ppeluffo/FWDLGARM_R1/Circuito del contador de pulsos.png

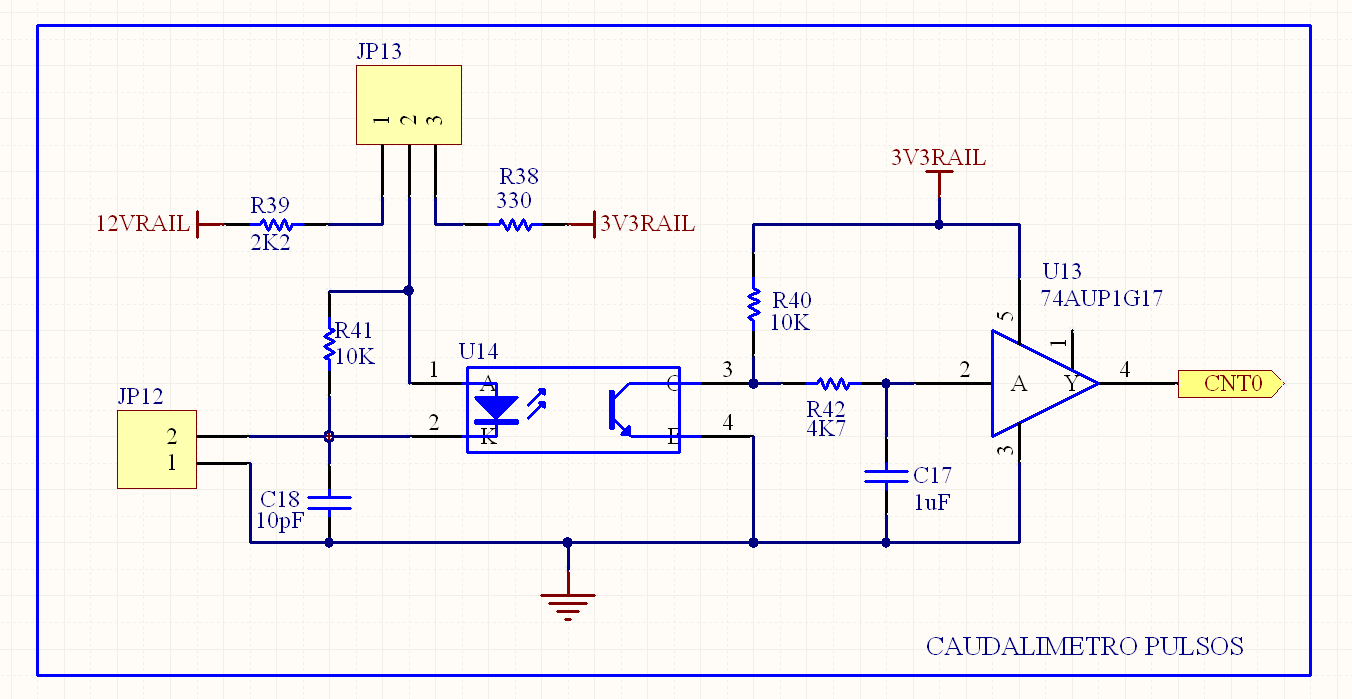
Circuito del contador de pulsos.png
