ppeluffo/FWDLGARM_R1/Fuente de 3V8.png

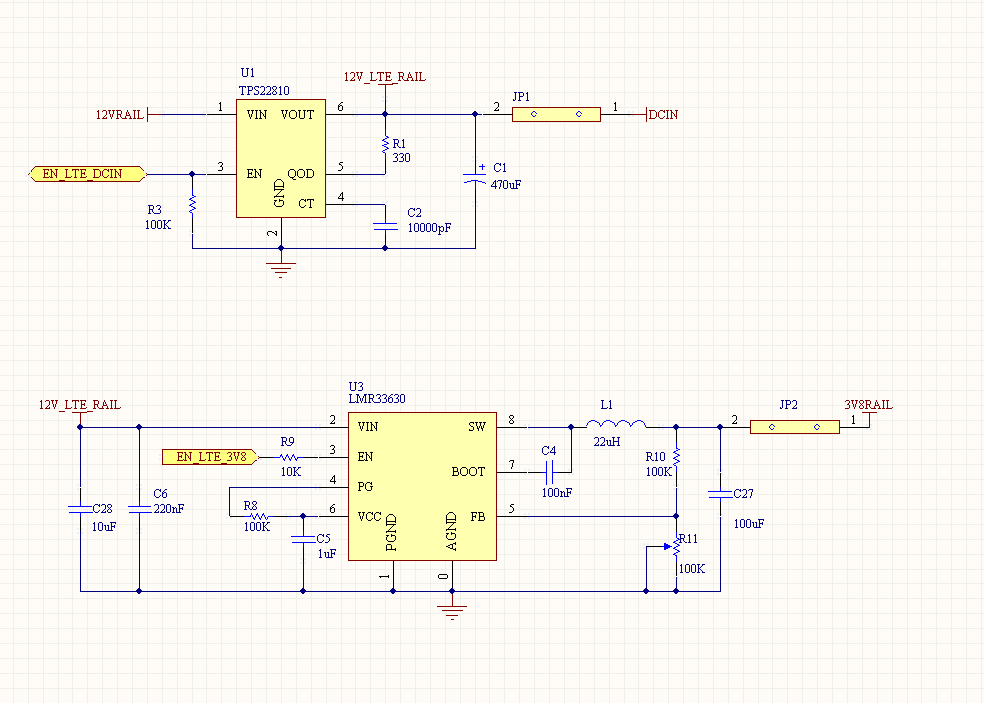
Fuente de 3V8.png
