ppeluffo/FWDLGARM_R1/Nueva fuente 3V8.png

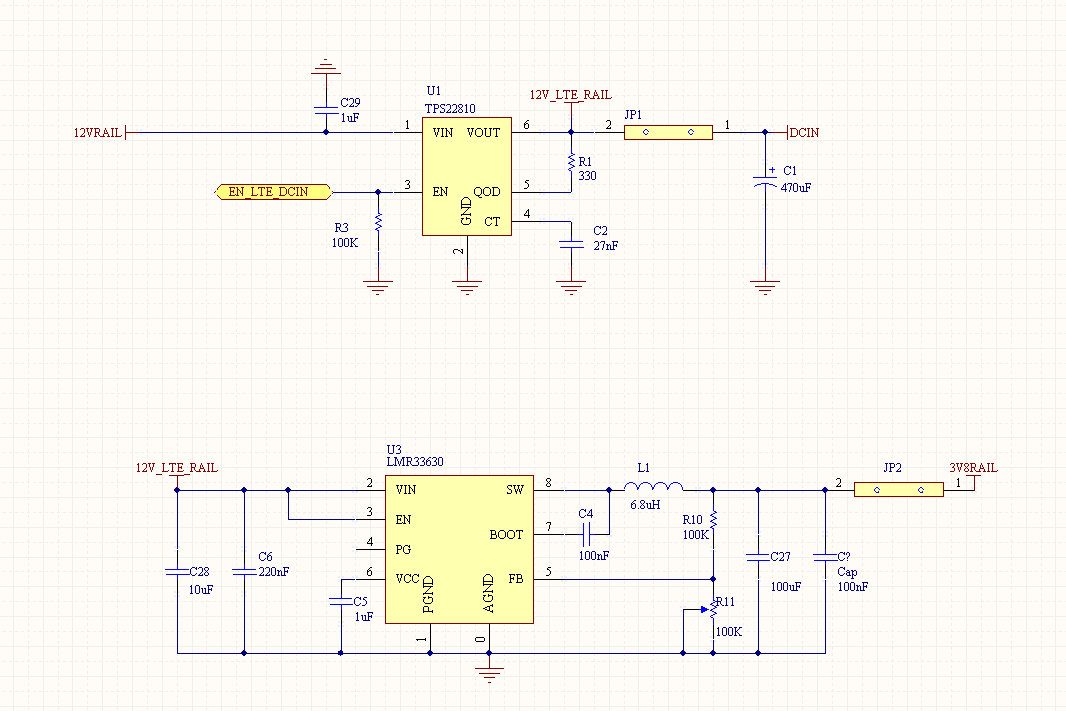
Nueva fuente 3V8.png
