ppeluffo/FWDLGARM_R1/Application/FRTOS-IO/frtos-io.c

/*
 * frtos-io.c  -  ver frtos-io.h
 */

#include <stdio.h>
#include <string.h>

#include "frtos-io.h"
#include "drv_uart.h"
#include "drv_i2c.h"
#include "drv_rs485.h"
#include "semphr.h"

/*------------------------------------------------------------------------------
 * Juego de operaciones de cada clase de periférico.
 *
 * Es lo que reemplaza a las cinco copias de frtos_{read,write,ioctl}_uartN del
 * código AVR: todas las UART comparten estas tres funciones y se distinguen por
 * el campo ucInstancia de la tabla de abajo.
 *----------------------------------------------------------------------------*/
typedef struct {
    int16_t ( *write )( uint8_t ucInstancia, const char *pvBuffer, uint16_t xBytes );
    int16_t ( *read  )( uint8_t ucInstancia, char *pvBuffer, uint16_t xBytes, TickType_t xTicksToWait );
    int16_t ( *ioctl )( uint8_t ucInstancia, uint32_t ulRequest, void *pvValue );
} frtos_ops_t;

/*------------------------------------------------------------------------------
 * Operaciones de UART
 *----------------------------------------------------------------------------*/

static int16_t prvUartWrite( uint8_t ucInstancia, const char *pvBuffer, uint16_t xBytes )
{
    return drv_uart_write( ( drv_uart_id_t ) ucInstancia, pvBuffer, xBytes );
}

static int16_t prvUartRead( uint8_t ucInstancia, char *pvBuffer, uint16_t xBytes, TickType_t xTicksToWait )
{
    return drv_uart_read( ( drv_uart_id_t ) ucInstancia, pvBuffer, xBytes, xTicksToWait );
}

static int16_t prvUartIoctl( uint8_t ucInstancia, uint32_t ulRequest, void *pvValue )
{
    drv_uart_id_t id = ( drv_uart_id_t ) ucInstancia;

    switch( ulRequest )
    {
        case ioctl_UART_CLEAR_RX_BUFFER:
            drv_uart_rx_flush( id );
            return 0;

        case ioctl_UART_ENABLE_RX:
        case ioctl_UART_ENABLE_RX_INT:
            return ( drv_uart_rx_enable( id ) == true ) ? 0 : -1;

        case ioctl_UART_DISABLE_RX:
        case ioctl_UART_DISABLE_RX_INT:
            drv_uart_rx_disable( id );
            return 0;

        case ioctl_SET_TIMEOUT:
            /* El timeout de lectura se pasa por fd, ver xTimeouts. */
            return 0;

        default:
            return -1;
    }
}

static const frtos_ops_t xUartOps = {
    .write = prvUartWrite,
    .read  = prvUartRead,
    .ioctl = prvUartIoctl,
};

/*------------------------------------------------------------------------------
 * Operaciones de I2C
 *
 * El I2C no encaja natural en una API estilo POSIX: `read(fd, buf, n)` no tiene
 * dónde decir a QUÉ chip ni a qué dirección interna. FWDLGX resolvió eso fijando
 * los tres datos por `ioctl` y dejándolos pegados al fd hasta el próximo cambio,
 * y acá se conserva **el mismo idioma con los mismos códigos**, para que el
 * código heredado del AVR compile sin tocarlo:
 *
 *     frtos_ioctl( fdI2C, ioctl_I2C_SET_DEVADDRESS,        &devAddr );
 *     frtos_ioctl( fdI2C, ioctl_I2C_SET_DATAADDRESS,       &memAddr );
 *     frtos_ioctl( fdI2C, ioctl_I2C_SET_DATAADDRESSLENGTH, &largo   );
 *     frtos_read ( fdI2C, buffer, n );
 *
 * ⚠ Es estado pegajoso y compartido: dos tareas usando fdI2C se pisarían los
 * parámetros entre el ioctl y el read, y el mutex de drv_i2c NO protege eso
 * —protege la transacción, que empieza después—. Por eso el acceso a los chips
 * va a ir siempre por sus drivers (EEPROM, RTC), que llaman a `drv_i2c_*`
 * directo y pasan todo junto. Esta fila existe para el código heredado.
 *----------------------------------------------------------------------------*/

static uint8_t  ucI2cDevAddr     = 0U;
static uint16_t usI2cMemAddr     = 0U;
static uint8_t  ucI2cMemAddrLen  = 1U;

static int16_t prvI2cWrite( uint8_t ucInstancia, const char *pvBuffer, uint16_t xBytes )
{
    ( void ) ucInstancia;
    return drv_i2c_write( ucI2cDevAddr, usI2cMemAddr, ucI2cMemAddrLen,
                          pvBuffer, xBytes, portMAX_DELAY );
}

static int16_t prvI2cRead( uint8_t ucInstancia, char *pvBuffer, uint16_t xBytes, TickType_t xTicksToWait )
{
    ( void ) ucInstancia;
    return drv_i2c_read( ucI2cDevAddr, usI2cMemAddr, ucI2cMemAddrLen,
                         pvBuffer, xBytes, xTicksToWait );
}

static int16_t prvI2cIoctl( uint8_t ucInstancia, uint32_t ulRequest, void *pvValue )
{
    ( void ) ucInstancia;

    switch( ulRequest )
    {
        case ioctl_I2C_SET_DEVADDRESS:
            if( pvValue == NULL ) { return -1; }
            ucI2cDevAddr = *( ( uint8_t * ) pvValue );
            return 0;

        case ioctl_I2C_SET_DATAADDRESS:
            if( pvValue == NULL ) { return -1; }
            usI2cMemAddr = *( ( uint16_t * ) pvValue );
            return 0;

        case ioctl_I2C_SET_DATAADDRESSLENGTH:
            if( pvValue == NULL ) { return -1; }
            ucI2cMemAddrLen = *( ( uint8_t * ) pvValue );
            return 0;

        case ioctl_I2C_GET_LAST_ERROR:
            if( pvValue == NULL ) { return -1; }
            *( ( uint32_t * ) pvValue ) = drv_i2c_last_error();
            return 0;

        case ioctl_I2C_RESET:
            return ( drv_i2c_reset() == true ) ? 0 : -1;

        default:
            return -1;
    }
}

static const frtos_ops_t xI2cOps = {
    .write = prvI2cWrite,
    .read  = prvI2cRead,
    .ioctl = prvI2cIoctl,
};

/*------------------------------------------------------------------------------
 * La tabla de file descriptors.
 *
 * Las filas en NULL son los periféricos cuyo hardware todavía no está poblado:
 * el fd existe para que el código de aplicación compile, pero cualquier
 * operación devuelve -1 en vez de escribir en un periférico inexistente.
 *----------------------------------------------------------------------------*/
typedef struct {
    const frtos_ops_t *pxOps;
    uint8_t            ucInstancia;
} frtos_fd_t;

static const frtos_fd_t xFdTable[ fdCOUNT ] = {
    [ fdTERM   ] = { &xUartOps, drvUART_TERM },
    [ fdWAN    ] = { &xUartOps, drvUART_LTE },
    [ fdRS485A ] = { &xUartOps, drvUART_RS485 },
    [ fdI2C    ] = { &xI2cOps, 0 },
    [ fdNVM    ] = { NULL, 0 },
};

/* Timeout de lectura por fd, lo fija ioctl_SET_TIMEOUT. Arranca en portMAX_DELAY:
   una lectura sin timeout explícito bloquea, que es lo que quiere la consola. */
static TickType_t xTimeouts[ fdCOUNT ];

static inline const frtos_fd_t *prvFd( file_descriptor_t fd )
{
    if( ( fd >= fdCOUNT ) || ( xFdTable[ fd ].pxOps == NULL ) )
    {
        return NULL;
    }
    return &xFdTable[ fd ];
}

/*------------------------------------------------------------------------------
 * API genérica
 *----------------------------------------------------------------------------*/

bool frtos_open_all( void )
{
    for( uint32_t i = 0U; i < fdCOUNT; i++ )
    {
        xTimeouts[ i ] = portMAX_DELAY;
    }

    /* El orden importa: drv_rs485_init() apaga rieles y toca la recepción de la
       UART del 485, así que la UART tiene que existir antes. */
    return ( drv_uart_init() && drv_i2c_init() && drv_rs485_init() );
}
//------------------------------------------------------------------------------
int16_t frtos_write( file_descriptor_t fd, const char *pvBuffer, uint16_t xBytes )
{
    const frtos_fd_t *px = prvFd( fd );

    return ( px != NULL ) ? px->pxOps->write( px->ucInstancia, pvBuffer, xBytes ) : -1;
}
//------------------------------------------------------------------------------
int16_t frtos_read( file_descriptor_t fd, char *pvBuffer, uint16_t xBytes )
{
    const frtos_fd_t *px = prvFd( fd );

    return ( px != NULL ) ? px->pxOps->read( px->ucInstancia, pvBuffer, xBytes, xTimeouts[ fd ] ) : -1;
}
//------------------------------------------------------------------------------
int16_t frtos_ioctl( file_descriptor_t fd, uint32_t ulRequest, void *pvValue )
{
    const frtos_fd_t *px = prvFd( fd );

    if( px == NULL )
    {
        return -1;
    }

    /* El timeout lo administra esta capa, no el driver: es una propiedad del fd. */
    if( ulRequest == ioctl_SET_TIMEOUT )
    {
        xTimeouts[ fd ] = ( pvValue != NULL ) ? *( ( TickType_t * ) pvValue ) : portMAX_DELAY;
        return 0;
    }

    return px->pxOps->ioctl( px->ucInstancia, ulRequest, pvValue );
}

/*------------------------------------------------------------------------------
 * printf
 *----------------------------------------------------------------------------*/

static char              cPrintfBuffer[ XPRINTF_BUFFER_SIZE ];
static SemaphoreHandle_t xPrintfMutex = NULL;
static StaticSemaphore_t xPrintfMutexCtrl;

static int prvVfprintf( file_descriptor_t fd, const char *fmt, va_list ap )
{
    /* Creación perezosa: xprintf() puede llamarse antes de frtos_open_all(). */
    if( xPrintfMutex == NULL )
    {
        xPrintfMutex = xSemaphoreCreateMutexStatic( &xPrintfMutexCtrl );
    }

    if( xSemaphoreTake( xPrintfMutex, portMAX_DELAY ) != pdTRUE )
    {
        return -1;
    }

    int iLen = vsnprintf( cPrintfBuffer, sizeof( cPrintfBuffer ), fmt, ap );

    if( iLen > 0 )
    {
        /* vsnprintf devuelve lo que HABRÍA escrito: si no entró, se manda lo que hay. */
        if( iLen >= ( int ) sizeof( cPrintfBuffer ) )
        {
            iLen = ( int ) sizeof( cPrintfBuffer ) - 1;
        }
        ( void ) frtos_write( fd, cPrintfBuffer, ( uint16_t ) iLen );
    }

    ( void ) xSemaphoreGive( xPrintfMutex );

    return iLen;
}
//------------------------------------------------------------------------------
int xprintf( const char *fmt, ... )
{
    va_list ap;
    va_start( ap, fmt );
    int iRet = prvVfprintf( fdTERM, fmt, ap );
    va_end( ap );
    return iRet;
}
//------------------------------------------------------------------------------
int xfprintf( file_descriptor_t fd, const char *fmt, ... )
{
    va_list ap;
    va_start( ap, fmt );
    int iRet = prvVfprintf( fd, fmt, ap );
    va_end( ap );
    return iRet;
}
//------------------------------------------------------------------------------
void xputChar( char c )
{
    ( void ) frtos_write( fdTERM, &c, 1U );
}
//------------------------------------------------------------------------------
