ppeluffo/FWDLGARM_R1/Application/tasks/wan_frame.h

/*
 * wan_frame.h
 *
 * El FRAME: la serialización de un `dataRcd_t` en el formato que entiende el
 * servidor. Portado de `wan_load_dr_in_txbuffer()` de FWDLGX 2.0.12
 * (`SRC/TASKS/FWDLGX_tkWAN.c`).
 *
 * ---------------------------------------------------------------------------
 * ⭐ ESTE ARCHIVO ES EL CONTRATO. NO ES UNA DECISIÓN DE DISEÑO.
 *
 * El servidor está en producción y no se toca. Pablo lo puso como la única
 * condición dura de la migración: *"Es importante mantener el formato de los
 * frames de datos ya que el servidor debe poder entendernos"*.
 *
 * O sea que acá **no se mejora nada**: ni el orden de los campos, ni la
 * cantidad de decimales, ni los nombres. Si algo parece raro —y hay cosas que lo
 * parecen— es porque así lo espera el otro lado.
 *
 * El formato:
 *
 *     ID=<imei>&HW=<hw>&TYPE=<type>&VER=<ver>&CLASS=DATA
 *     &DATE=YYMMDD&TIME=HHMMSS
 *     &<nombre>=%0.2f     por cada analógica HABILITADA
 *     &<nombre>=%0.3f     el contador, si está habilitado
 *     &<nombre>=%0.3f     por cada canal modbus habilitado
 *     &V0=<0|1>           la válvula: 0 = abierta, 1 = cerrada
 *     &bt3v3=%0.3f
 *     &bt12v=%0.3f
 *
 * Tres cosas que hay que tener presentes:
 *
 *  - **Los nombres de los campos salen de la configuración**, no son fijos: el
 *    servidor los aprende del frame de configuración. Por eso dos canales con el
 *    mismo nombre rompen el frame — ver `cfg_nvm_chequear_nombres()`.
 *  - **Sólo se emiten los canales habilitados**, así que el conjunto de campos
 *    varía de equipo a equipo.
 *  - **Las precisiones son distintas a propósito**: 2 decimales las analógicas,
 *    3 el contador y los modbus. No unificarlas.
 *
 * `CLASS=DATA` espera respuesta del servidor; `CLASS=DATANR` no ("no response"),
 * y es lo que se usa al vaciar la memoria de golpe.
 *
 * ---------------------------------------------------------------------------
 * EL CENTINELA -9999 (decisión de Pablo, 2026-09-08)
 *
 * Un campo que no se pudo medir viaja como **-9999**, no se omite.
 *
 * El razonamiento es de Pablo y es el correcto: *"si no lo transmitimos el
 * servidor no lo detecta"*. Un campo **ausente** se confunde con un canal
 * deshabilitado y pasa desapercibido; un **-9999** salta a la vista, y como las
 * magnitudes que mide este equipo son positivas, no puede confundirse con una
 * medida real.
 *
 * Es el mismo criterio que el `SIN_DATO` de la consola, la firma del MCP79410
 * para la hora y el `estado_asumido` de la válvula: **hacer visible lo que no se
 * sabe**, en vez de dejar que se mezcle con lo que sí.
 *
 * ⚠ La HORA es la excepción, y no por descuido: no es un campo numérico, así que
 * el centinela no aplica. Si el reloj arrancó frío viaja su fecha tal cual
 * —`010101`— que del lado del servidor es tan detectable como un -9999.
 */

#ifndef APPLICATION_TASKS_WAN_FRAME_H_
#define APPLICATION_TASKS_WAN_FRAME_H_

#include <stdbool.h>
#include <stdint.h>

#include "tkSys.h"
#include "drv_rtc79410.h"

/* Lo que va en un campo que no se pudo medir. Ver arriba. */
#define WAN_CENTINELA_SIN_DATO      ( -9999.0f )

/*
 * 512 bytes. En el AVR eran 255 y **se desbordaban**: con los 9 canales
 * habilitados y nombres normales el frame pasa de 255 y allá corrompía variables
 * globales — está documentado en el propio `wan_load_dr_in_txbuffer()`. Acá la
 * RAM sobra, así que el buffer se dimensionó para el peor caso con holgura.
 */
#define WAN_FRAME_BUFFER_SIZE       512U

/*------------------------------------------------------------------------------
 * Arma el frame de datos en `pcBuf`. Devuelve los bytes escritos (sin el NUL), o
 * 0 si no entró — y en ese caso lo avisa por consola en vez de mandar un frame
 * truncado, que del otro lado sería un registro con campos perdidos.
 *
 * `bConRespuesta` elige entre `CLASS=DATA` y `CLASS=DATANR`.
 *----------------------------------------------------------------------------*/
uint16_t wan_frame_data( char *pcBuf, uint16_t usSize, const dataRcd_t *pxDr,
                         bool bConRespuesta );

/*------------------------------------------------------------------------------
 * EL FRAME PARTIDO EN DOS, y por qué (decisión de Pablo, 2026-09-21)
 *
 *   wan_frame_prefijo()  ID=<imei>&HW=..&TYPE=..&VER=..&CLASS=..
 *   wan_frame_datos()    DATE=..&TIME=..&<canales>&V0=..&bt3v3=..&bt12v=..
 *
 * `wan_frame_data()` es la concatenación de las dos con un `&` en el medio, y
 * es lo que se transmite. **El formato que viaja no cambia en un solo byte.**
 *
 * ⭐ **La partición existe porque en la microSD se guarda SÓLO la parte de
 * datos**, y el prefijo se construye al transmitir. Lo que hay en el prefijo no
 * pertenece al dato, pertenece al transporte:
 *
 *  - ⛔ **`ID` es el IMEI del módulo.** Guardándolo, un lote que quede pendiente
 *    y se transmita después de cambiar el módulo LTE **saldría con el IMEI
 *    viejo**, y el servidor lo atribuiría a otro equipo o lo rechazaría. No es
 *    hipotético: el módulo de este banco ya se movió a un AVR para una prueba.
 *  - **`CLASS` es una decisión de transmisión**, no del dato: el mismo registro
 *    va como `DATANR` o como `DATA` según cierre bloque o no. Guardarlo obligaba
 *    a reescribirlo al transmitir.
 *  - `HW`/`TYPE` no cambian nunca, y `VER` congelado hasta sería deseable — pero
 *    no valen el precio de los dos primeros.
 *
 * De yapa la línea del lote baja de ~120 a ~55 bytes, menos de la mitad.
 *
 * ⭐ Y se conserva **la razón principal** por la que en la SD van frames de
 * texto y no registros binarios: los **nombres de los canales** siguen
 * guardados con los que se midió, así que no reaparece el problema de
 * "configuración nueva con datos viejos".
 *----------------------------------------------------------------------------*/
uint16_t wan_frame_prefijo( char *pcBuf, uint16_t usSize, bool bConRespuesta );
uint16_t wan_frame_datos  ( char *pcBuf, uint16_t usSize, const dataRcd_t *pxDr );

/*------------------------------------------------------------------------------
 * El IMEI, que es el `ID` con el que el servidor identifica al equipo.
 *
 * ⏳ **HOY DEVUELVE UN IMEI FALSO, Y ES PROVISORIO DE ESTA ETAPA** (acordado con
 * Pablo, 2026-09-08): esta etapa no incluye el modem, así que no hay de dónde
 * sacar el real.
 *
 * **Lo definitivo, para el paso 5**: tkWAN prende el modem al arrancar, le
 * pregunta el IMEI con `AT+IMEI?` y lo cachea; **queda fijado aunque después el
 * modem se apague**, así que el frame nunca necesita el modem encendido para
 * armarse. Sólo hay que reemplazar lo que devuelve esta función.
 *
 * ⚠ **El valor falso son 15 ceros a propósito.** Es sintácticamente un IMEI, así
 * que no rompe el parseo del servidor, pero **ningún equipo real lo tiene**: si
 * un frame de prueba llegara por error al servidor de producción, sería
 * rechazado como equipo desconocido en vez de mezclarse con los datos de un
 * datalogger que existe. Por eso no se usó el IMEI de un módulo real de los que
 * andan dando vueltas en las notas.
 *----------------------------------------------------------------------------*/
const char *wan_imei( void );

/*------------------------------------------------------------------------------
 * true mientras el IMEI siga siendo el falso de 15 ceros, o sea **mientras nadie
 * se lo haya preguntado al módulo**.
 *
 * ⛔ Existe porque el 2026-09-21 se transmitió una sesión entera con los ceros
 * sin que nada lo dijera: el IMEI se cachea recién cuando alguien corre
 * `lte info`, y esa corrida empezó con `lte clock set`. El servidor aceptó los
 * frames igual, así que **quedaron en la base atribuidos a un equipo que no
 * existe** — y del lado del datalogger no hubo ni una señal.
 *
 * Quien vaya a transmitir tiene que consultarlo y avisar. ⏳ Cuando exista la
 * FSM (paso 5d), el IMEI se lee al abrir la sesión y esto pasa a ser una red de
 * seguridad en vez del mecanismo principal.
 *----------------------------------------------------------------------------*/
bool wan_imei_es_falso( void );

/*------------------------------------------------------------------------------
 * Fija el IMEI leído del módulo. Lo llama quien haya hecho el `AT+IMEI?`.
 *
 * Se guarda **una vez por corrida**: el módulo puede apagarse entre sesiones,
 * pero su IMEI no cambia. Así el frame se arma sin necesitar el modem encendido.
 *----------------------------------------------------------------------------*/
void wan_imei_set( const char *pcImei );

/*------------------------------------------------------------------------------
 * Los otros dos datos que el módulo sabe y el frame de configuración necesita.
 *
 * `ICCID` identifica a la SIM y `CSQ` es la calidad de señal — los dos se leen
 * con AT y se cachean, igual que el IMEI.
 *
 * ⚠ **El `CSQ` que viaja en el frame NO es el `rssi` crudo del módulo**: es el
 * valor absoluto de los dBm, `|dBm| = 113 - 2·rssi`, que es lo que manda el AVR
 * (`+CSQ: 20,99` → `CSQ=73`). Convertirlo acá y no en el frame deja el dato
 * listo en la unidad del contrato.
 *
 * ⚠ Y dos valores de `rssi` NO son medidas, son centinelas —lo descubrió el AVR
 * en mayo de 2026 y a nosotros nos costó una tarde el 2026-09-09—:
 *
 *   - **99** = "desconocido / no detectable" (3GPP).
 *   - **>= 31** = lo que devuelve el módulo **ANTES de campar en la red**. Se ve
 *     como señal excelente y no lo es: le sigue un `+CME ERROR:50` en `AT+CIP?`
 *     y el equipo no transmite nada.
 *----------------------------------------------------------------------------*/
void wan_iccid_set( const char *pcIccid );
void wan_csq_set  ( uint8_t ucRssi );

const char *wan_iccid( void );
uint8_t     wan_csq  ( void );      /* ya convertido a |dBm| */

/* true si el `rssi` crudo era una medida y no un centinela. */
bool wan_csq_valido( void );

/*------------------------------------------------------------------------------
 * El frame de CONFIGURACIÓN: manda un hash por bloque y el servidor contesta
 * cuáles quiere reconfigurar.
 *
 * ⛔ **Van CINCO hashes: el `FH` de flowcontrol NO se manda, y es deliberado.**
 *
 * Ese bloque llegó a estar implementado —configuración, hash y parseo— y **se
 * eliminó entero el 2026-09-22** por decisión de Pablo: *"Esta es una
 * funcionalidad que aún no la estamos usando, así que no vamos a ensuciar el
 * firmware con features que no se usan."*
 *
 * ⚠ **Y el servidor se ajustó para acompañarlo**: ya no pide `FLOWC` ni espera
 * su hash. O sea que esto **no es la situación transitoria de antes** —donde
 * `CONF_ALL` nunca podía cerrar porque faltaba un hash que el servidor sí
 * esperaba—: ahora las dos puntas están de acuerdo en que son cinco.
 *
 * ⭐ **La regla de que la FSM pase a transmitir datos aunque queden bloques
 * pedidos sigue valiendo igual.** Era lo correcto cuando existía el `FLOWC` que
 * no se podía satisfacer, y lo sigue siendo ante *cualquier* bloque que falle:
 * si esperara el `OK`, uno solo rechazado dejaría al equipo sin transmitir una
 * muestra.
 */
uint16_t wan_frame_conf_all( char *pcBuf, uint16_t usSize );

/*------------------------------------------------------------------------------
 * Qué pidió reconfigurar el servidor. `bFlowcontrol` se parsea igual **aunque no
 * se implemente**: verlo en la consola explica por qué la configuración nunca
 * cierra, y sin eso parecería un error.
 *----------------------------------------------------------------------------*/
typedef struct {
    bool bBase;
    bool bAinputs;
    bool bCounter;
    bool bModbus;
    bool bConsigna;
    /* ⚠ Se PARSEA aunque el bloque no exista: si un servidor viejo lo pidiera,
       verlo en la consola explica por qué la configuración no cierra. Sin esto
       parecería un error del equipo. */
    bool bFlowcontrol;
} wan_conf_flags_t;

typedef enum {
    wanCONF_OK = 0,         /* CONFIG=OK: no hay nada que reconfigurar        */
    wanCONF_RECONFIGURAR,   /* el servidor listó bloques -> ver las flags     */
    wanCONF_DESCONOCIDO,    /* CONFIG=ERROR / FAIL: no nos reconoce           */
    wanCONF_SIN_RESPUESTA
} wan_conf_rta_t;

wan_conf_rta_t wan_frame_conf_all_rta( const char *pcRta, wan_conf_flags_t *pxFlags );

/*------------------------------------------------------------------------------
 * Los bloques de configuración, en el orden en que se los pide.
 *----------------------------------------------------------------------------*/
typedef enum {
    wanBLOQUE_BASE = 0,
    wanBLOQUE_AINPUTS,
    wanBLOQUE_COUNTER,
    wanBLOQUE_MODBUS,
    wanBLOQUE_CONSIGNA,
    wanBLOQUE_NRO          /* centinela: cuántos son */
} wan_bloque_t;

/* El nombre de la clase tal como viaja: "CONF_BASE", "CONF_AINPUTS", … */
const char *wan_conf_clase( wan_bloque_t eBloque );

/* true si el servidor pidió reconfigurar ESE bloque. Evita que cada llamador
   tenga que escribir su propio switch sobre los campos de la struct. */
bool wan_conf_pedido( const wan_conf_flags_t *pxFlags, wan_bloque_t eBloque );

/*------------------------------------------------------------------------------
 * El frame de un bloque: manda su hash y el servidor contesta con la
 * configuración que quiere que tenga el equipo.
 *
 * ⚠ **`CONF_BASE` lleva UID, ICCID, CSQ y WDG; los otros cuatro NO.** Es una
 * asimetría del AVR —ver `wan_process_frame_configBase()` contra los otros
 * cuatro— y se reproduce tal cual: es el contrato, no una decisión.
 *----------------------------------------------------------------------------*/
uint16_t wan_frame_conf_bloque( char *pcBuf, uint16_t usSize, wan_bloque_t eBloque );

/*------------------------------------------------------------------------------
 * Parsea la respuesta de un bloque y **aplica la configuración en RAM**.
 *
 * Formatos (los del AVR, `wan_process_rsp_config*`):
 *
 *   CLASS=CONF_BASE&TPOLL=30&TDIAL=900&PWRMODO=CONTINUO&PWRON=1800&PWROFF=1440
 *   CLASS=CONF_AINPUTS&PST=12&A0=true,pA,4,20,0.0,10.0,0.0&A1=…&A2=…
 *   CLASS=CONF_COUNTERS&C0=TRUE,CAU0,5.3,CAUDAL,200.0,0.25
 *   CLASS=CONF_MODBUS&ENABLE=TRUE&LOCALADDR=2&M0=TRUE,CAU0,2,2069,2,3,FLOAT,C1032,0&…
 *   CLASS=CONF_CONSIGNA&ENABLE=TRUE&DIURNA=700&NOCTURNA=2300
 *
 * ⚠ El comentario del AVR sobre `CONF_COUNTERS` muestra **cuatro** campos y está
 * desactualizado: su código parsea **seis** (agrega `qmax` y `alpha`). Vale el
 * código, no el comentario.
 *
 * ⚠ **NO graba en la EEPROM**: eso lo decide el llamador, con un solo
 * `cfg_nvm_save_all()` al final y sólo si algún bloque devolvió
 * `wanCONF_RECONFIGURAR`. Grabar bloque por bloque serían cinco escrituras de
 * las que cuatro podrían quedar a medias si la sesión se corta.
 *
 * ⚠ **`wanCONF_DESCONOCIDO` NO se actúa acá.** El AVR, ante un `CONFIG=ERROR`,
 * reconfigura el equipo a `PWR_DISCRETO` con los timers en 3600 para reintentar
 * en una hora. Eso es **política de la máquina de estados** y entra con ella en
 * el paso 5c: acá se informa y nada más. Si se hiciera desde un comando de
 * banco, probar la configuración cambiaría el modo de operación del equipo sin
 * que nadie lo pidiera.
 *----------------------------------------------------------------------------*/
wan_conf_rta_t wan_conf_aplicar( wan_bloque_t eBloque, const char *pcRta );

/*------------------------------------------------------------------------------
 * LA RESPUESTA A UN FRAME DE DATOS
 *
 * El servidor contesta `CLASS=DATA` y **puede agregar órdenes**. De las que
 * conoce el AVR, acá se implementan dos (acordado con Pablo, 2026-09-11):
 *
 *   CLOCK=YYMMDDhhmm   pone en hora el equipo
 *   RESET              reiniciar
 *
 * ✅ Y desde el 2026-09-22, las **seis órdenes de válvula**:
 *
 *   VOPEN / VCLOSE                 la válvula TOYI **interna**  -> `tkFlow`
 *   EXT_V0_OPEN  / EXT_V0_CLOSE    la V0 del **control de presión** -> `tkCtlPres`
 *   EXT_V1_OPEN  / EXT_V1_CLOSE    la V1        "        "
 *
 * ⚠ **Ninguna se ejecuta acá: se despachan por notificación.** Mover la TOYI son
 * 5 s y una orden al control de presión son ~14; hacerlo dentro del parseo
 * dejaría la sesión con el servidor congelada en medio de un vaciado.
 *----------------------------------------------------------------------------*/
typedef enum {
    wanDATA_ACEPTADO = 0,   /* el servidor contestó `CLASS=DATA`              */
    /*
     * ⚠ **`VACIA` y `OTRA_CLASE` apuntan a causas OPUESTAS**, y por eso están
     * separadas (banco, 2026-09-18):
     *
     *  - **VACIA**: llegó `<html></html>` sin un solo `CLASS=`. El servidor
     *    **recibió y contestó**, o sea que el enlace y el GET están bien: lo
     *    que rechazó es el CONTENIDO del frame. Hay que mirar el log del
     *    servidor, no el del equipo.
     *  - **OTRA_CLASE**: contestó con un `CLASS=` que no es `DATA`. Eso es un
     *    cruce de respuestas — típicamente la respuesta demorada del frame
     *    anterior.
     *
     * Confundirlas manda a buscar al lugar equivocado, que es exactamente lo
     * que ya costó una tarde con el `CSQ 31`.
     */
    wanDATA_VACIA,
    wanDATA_OTRA_CLASE,
    wanDATA_SIN_RESPUESTA
} wan_data_rta_t;

/*
 * `bReset` NO se ejecuta acá: se informa y lo hace el llamador. Reiniciar en
 * medio del procesamiento de una respuesta dejaría a medias todo lo que venga
 * después —incluido el `pop()` de los registros ya confirmados—, y el equipo
 * volvería a transmitir lo mismo después del reset.
 */
typedef struct {
    bool bClock;     /* vino un `CLOCK=` válido y se aplicó */
    bool bReset;     /* el servidor pide reiniciar          */
    uint8_t ucValvulas;  /* cuántas órdenes de válvula se despacharon */
} wan_data_ordenes_t;

wan_data_rta_t wan_frame_data_rta( const char *pcRta, wan_data_ordenes_t *pxOrdenes );

/*------------------------------------------------------------------------------
 * Pone el RTC en hora desde una fuente externa, **y de paso MIDE la deriva**.
 *
 * Hay dos fuentes y llegan en momentos distintos, por eso las dos pasan por acá:
 *
 * | Fuente | Cuándo | Qué resuelve |
 * |---|---|---|
 * | el `CLOCK=` del servidor | en la respuesta a un frame de datos | la **deriva** en operación normal — es lo que hace el AVR |
 * | `AT+CCLK?` del módulo (NTP) | al abrir la sesión, **antes de medir** | el **arranque en frío**: el `CLOCK` llega tarde, cuando los registros ya se grabaron con fecha 2001 |
 *
 * ⭐ **La medición de deriva vive acá y no en el comando de consola a
 * propósito.** Si el servidor corrige la hora en cada sesión —que es lo que
 * hace—, el reloj siempre se ve bien y **la deriva del cristal queda tapada
 * para siempre**. Poniendo la medición en el punto donde se aplica la
 * corrección, cada ajuste informa cuántos ppm se desvió: el dato que decide si
 * hay que cambiar los condensadores de carga de la placa.
 *
 * `bSiempre` salta el umbral de 90 s. Lo usa el comando manual (`lte clock
 * set`); el camino automático lo deja en false para no reajustar en cada poleo.
 *
 * Devuelve true si efectivamente escribió el RTC.
 *----------------------------------------------------------------------------*/
/*------------------------------------------------------------------------------
 * Interpreta la respuesta de `AT+CCLK?`: `+CCLK: "26/09/21,11:04:08-12"`.
 *
 * Rechaza lo que no tenga la forma exacta, lo que esté fuera de rango, y **un
 * año anterior al de compilación** —que significa que el módulo todavía no
 * sincronizó con la red—.
 *
 * Lo usan el comando `lte clock` y la FSM; está acá para que sean el mismo
 * parseo y no dos copias.
 *----------------------------------------------------------------------------*/
bool wan_cclk_parsear( const char *pcRta, RtcTimeType_t *pxHora );

bool wan_rtc_sincronizar( const RtcTimeType_t *pxNueva, const char *pcOrigen,
                          bool bSiempre );

/*------------------------------------------------------------------------------
 * El frame de PING, que es el primero de toda sesión: pregunta si el servidor
 * está del otro lado. La respuesta esperada es `CLASS=PONG`.
 *
 * No lleva datos ni fecha — sólo la identidad del equipo.
 *----------------------------------------------------------------------------*/
uint16_t wan_frame_ping( char *pcBuf, uint16_t usSize );

#endif /* APPLICATION_TASKS_WAN_FRAME_H_ */
