ppeluffo/FWDLGARM_R1/Application/drivers/drv_modbus.c

/*
 * drv_modbus.c
 *
 * La transacción Modbus RTU. El porqué del diseño está en el header.
 */

#include <string.h>

#include "drv_modbus.h"
#include "drv_rs485.h"
#include "frtos-io.h"

//------------------------------------------------------------------------------
/*
 * Una respuesta de lectura son 5 + 2*N bytes; una de escritura, 8. El `+ 4` es
 * aire para que una trama con basura pegada al final no se descarte por largo
 * antes de que el CRC pueda opinar.
 */
#define MB_RX_BUFFER    ( 5U + DRV_MODBUS_MAX_PAYLOAD + 4U )
#define MB_TX_BUFFER    8U      /* SLA + FC + 2 + 2 + CRC: los tres fcodes     */

static uint8_t pucTx[ MB_TX_BUFFER ];
static uint8_t pucRx[ MB_RX_BUFFER ];

static bool    bDebug     = false;
static uint8_t ucExcepcion = 0U;

//------------------------------------------------------------------------------
uint16_t drv_modbus_crc16( const uint8_t *pucMsg, uint8_t ucSize )
{
    /*
     * El CRC de Modbus: polinomio 0xA001 (reflejado), semilla 0xFFFF. Portado
     * **tal cual** del AVR, que a su vez es el de la especificación.
     *
     * ⚠ El resultado sale con los bytes al revés de como viajan: el LOW va
     * primero en la trama. Los llamadores de acá lo tienen en cuenta.
     */
    uint16_t usCrc = 0xFFFFU;
    uint16_t usPos;
    int      i;

    if( pucMsg == NULL )
    {
        return 0U;
    }

    for( usPos = 0U; usPos < ucSize; usPos++ )
    {
        usCrc ^= ( uint16_t ) pucMsg[ usPos ];

        for( i = 8; i != 0; i-- )
        {
            if( ( usCrc & 0x0001U ) != 0U )
            {
                usCrc >>= 1;
                usCrc ^= 0xA001U;
            }
            else
            {
                usCrc >>= 1;
            }
        }
    }

    return usCrc;
}
//------------------------------------------------------------------------------
const char *drv_modbus_error_str( mb_result_t eRes )
{
    switch( eRes )
    {
        case mbOK:               return "OK";
        case mbPARAMETRO:        return "parametro fuera de rango (no se transmitio)";
        case mbBUS_APAGADO:      return "el riel del RS485 esta apagado";
        case mbSIN_RESPUESTA:    return "SIN RESPUESTA (timeout)";
        case mbTRAMA_CORTA:      return "trama demasiado corta";
        case mbCRC:              return "CRC ERROR";
        case mbOTRO_ESCLAVO:     return "contesto OTRO esclavo";
        case mbOTRO_FCODE:       return "la respuesta es de otra funcion";
        case mbEXCEPCION:        return "EXCEPCION del esclavo";
        case mbLARGO_INESPERADO: return "el byte count no coincide con lo pedido";
        default:                 return "?";
    }
}
//------------------------------------------------------------------------------
void drv_modbus_debug( bool bOn )
{
    bDebug = bOn;
}
//------------------------------------------------------------------------------
bool drv_modbus_debug_estado( void )
{
    return bDebug;
}
//------------------------------------------------------------------------------
uint8_t drv_modbus_ultima_excepcion( void )
{
    return ucExcepcion;
}
//------------------------------------------------------------------------------
static void prvTraza( const char *pcQue, const uint8_t *pucBuf, uint8_t ucLargo )
{
    uint8_t i;

    if( !bDebug )
    {
        return;
    }

    xprintf( "MB %s (%u):", pcQue, ( unsigned ) ucLargo );

    for( i = 0U; i < ucLargo; i++ )
    {
        xprintf( "[%02X]", ( unsigned ) pucBuf[ i ] );
    }

    xprintf( "\r\n" );
}
//------------------------------------------------------------------------------
/*
 * ⛔ LEE LA RESPUESTA TOLERANDO BASURA ANTES Y DESPUÉS
 *
 * La primera versión llamaba una sola vez a `drv_rs485_read_frame()`, y eso
 * falló en banco contra el control de presión (2026-09-22):
 *
 *     MB TX (8):[64][03][00][01][00][01][DC][3F]
 *     MB RX (1):[00]                              <- y ahí se cortaba
 *
 * **El `0x00` no lo manda el esclavo: lo genera el BUS.** Se comprobó pidiéndole
 * a una dirección que no existe —la 99— y devolvió exactamente lo mismo. Es el
 * artefacto que deja la línea al soltarse el DE: sin nadie manejando el par, el
 * receptor ve un nivel indefinido, interpreta un start bit falso y entrega un
 * byte de ceros.
 *
 * ⚠ **Y la lectura por trama lo tomaba por la respuesta.** `read_frame()` espera
 * el primer byte y a partir de ahí corta al primer silencio de `t3.5`, así que
 * ese byte espurio **terminaba la lectura** y la respuesta de verdad —que llega
 * decenas de ms después— se perdía.
 *
 * ⭐ Por qué el AVR no lo sufre, y es el mismo patrón de los acuses rezagados de
 * los `DATANR`: aquel **acumula todo durante un segundo** en un buffer lineal y
 * recién después busca la respuesta ahí adentro, así que la basura del principio
 * le queda delante sin molestar. Leer una trama delimitada por silencio es mejor
 * para todo lo demás —bloquea en el kernel en vez de polear— pero **tiene que
 * tolerar lo que aquel buffer toleraba sin pensarlo.**
 *
 * Acá se resuelve con tres cosas, y ninguna sobra:
 *
 *   1. **Se sigue leyendo** hasta juntar el largo esperado o agotar el timeout
 *      total, en vez de conformarse con la primera trama.
 *   2. **Se descarta el prefijo hasta la dirección del esclavo.** Modbus RTU no
 *      tiene byte de inicio, así que lo primero que puede ser una respuesta es
 *      el SLA: cualquier cosa antes es ruido por definición.
 *   3. **Se trunca al largo esperado**, porque el mismo artefacto puede aparecer
 *      DESPUÉS de la respuesta — y ahí sería peor: el CRC se calcularía tomando
 *      el byte de ruido como parte de la trama y fallaría una respuesta buena.
 */
static int16_t prvLeerRespuesta( uint8_t ucSla, uint8_t ucLargoEsperado )
{
    TickType_t xLimite = xTaskGetTickCount() +
                         pdMS_TO_TICKS( DRV_MODBUS_MS_TIMEOUT );
    uint16_t   usTotal = 0U;

    for( ;; )
    {
        TickType_t xAhora = xTaskGetTickCount();

        if( ( xAhora >= xLimite ) || ( usTotal >= sizeof( pucRx ) ) )
        {
            break;
        }

        int16_t sLeidos = drv_rs485_read_frame( ( char * ) &pucRx[ usTotal ],
                                                ( uint16_t ) ( sizeof( pucRx ) - usTotal ),
                                                xLimite - xAhora,
                                                pdMS_TO_TICKS( DRV_MODBUS_MS_SILENCIO ) );

        if( sLeidos <= 0 )
        {
            break;      /* se agotó el tiempo sin que llegara nada más */
        }

        usTotal += ( uint16_t ) sLeidos;

        /* ---- 2. Sincronizar: tirar todo lo que haya antes del SLA ---- */
        uint16_t i = 0U;

        while( ( i < usTotal ) && ( pucRx[ i ] != ucSla ) )
        {
            i++;
        }

        if( i > 0U )
        {
            if( bDebug )
            {
                xprintf( "MB: descartados %u byte(s) de ruido antes de la respuesta\r\n",
                         ( unsigned ) i );
            }

            usTotal = ( uint16_t ) ( usTotal - i );

            if( usTotal > 0U )
            {
                memmove( pucRx, &pucRx[ i ], usTotal );
            }
        }

        /*
         * ⚠ Una EXCEPCIÓN son 5 bytes y no el largo esperado, así que hay que
         * reconocerla acá o se esperaría el timeout entero por una respuesta que
         * ya llegó completa.
         */
        if( ( usTotal >= 5U ) &&
            ( ( pucRx[ 1 ] & 0x80U ) != 0U ) )
        {
            usTotal = 5U;
            break;
        }

        if( usTotal >= ucLargoEsperado )
        {
            /* ---- 3. Truncar: el ruido también puede venir DESPUÉS ---- */
            usTotal = ucLargoEsperado;
            break;
        }
    }

    return ( int16_t ) usTotal;
}
//------------------------------------------------------------------------------
/*
 * Manda el ADU que está en `pucTx` y trae la respuesta a `pucRx`.
 *
 * El CRC del pedido se calcula acá, no en el llamador: así no hay forma de
 * transmitir una trama sin CRC, que es un error que en el AVR es posible porque
 * cada sitio se lo agrega por su cuenta.
 */
static int16_t prvTransaccion( uint8_t ucLargoSinCrc, uint8_t ucLargoEsperado )
{
    uint16_t usCrc = drv_modbus_crc16( pucTx, ucLargoSinCrc );

    pucTx[ ucLargoSinCrc++ ] = ( uint8_t ) ( usCrc & 0x00FFU );          /* LOW  */
    pucTx[ ucLargoSinCrc++ ] = ( uint8_t ) ( ( usCrc & 0xFF00U ) >> 8 ); /* HIGH */

    /*
     * ⚠ Limpiar el buffer de RX **antes** de transmitir, no después de recibir.
     * Lo que haya quedado de una transacción anterior —una respuesta que llegó
     * tarde, el eco de una colisión— se tomaría por la respuesta de ésta. Es el
     * mismo cuidado que `drv_lte_at()` y por la misma razón.
     */
    drv_rs485_rx_flush();

    prvTraza( "TX", pucTx, ucLargoSinCrc );

    if( drv_rs485_write( ( const char * ) pucTx, ucLargoSinCrc ) != ( int16_t ) ucLargoSinCrc )
    {
        return -1;
    }

    int16_t sLeidos = prvLeerRespuesta( pucTx[ 0 ], ucLargoEsperado );

    if( sLeidos > 0 )
    {
        prvTraza( "RX", pucRx, ( uint8_t ) sLeidos );
    }
    else if( bDebug )
    {
        xprintf( "MB RX: nada en %u ms\r\n", ( unsigned ) DRV_MODBUS_MS_TIMEOUT );
    }

    return sLeidos;
}
//------------------------------------------------------------------------------
/*
 * Lo común a las dos operaciones: largo mínimo, CRC, dirección, fcode y
 * excepción. **El orden importa y no es arbitrario.**
 *
 * El CRC va PRIMERO —antes que la dirección o el fcode— porque con el CRC malo
 * la trama no se puede interpretar en absoluto: leer el byte 0 de una trama
 * corrupta y anunciar "contestó otro esclavo" sería inventar un diagnóstico
 * sobre datos que ya se sabe que están mal. El protocolo dice exactamente eso:
 * una trama con CRC incorrecto **se ignora**.
 */
static mb_result_t prvValidar( int16_t sLeidos, uint8_t ucSla, uint8_t ucFcode )
{
    if( sLeidos <= 0 )
    {
        return mbSIN_RESPUESTA;
    }

    /* Lo más corto que puede ser una respuesta válida es una excepción: SLA +
       FC|0x80 + código + CRC = 5 bytes. */
    if( sLeidos < 5 )
    {
        return mbTRAMA_CORTA;
    }

    uint8_t  ucLargo  = ( uint8_t ) sLeidos;
    uint16_t usCalc   = drv_modbus_crc16( pucRx, ucLargo - 2U );
    uint16_t usRecib  = ( uint16_t ) pucRx[ ucLargo - 2U ] |
                        ( ( uint16_t ) pucRx[ ucLargo - 1U ] << 8 );

    if( usCalc != usRecib )
    {
        if( bDebug )
        {
            xprintf( "MB: CRC rx=0x%04X calc=0x%04X\r\n",
                     ( unsigned ) usRecib, ( unsigned ) usCalc );
        }
        return mbCRC;
    }

    if( pucRx[ 0 ] != ucSla )
    {
        return mbOTRO_ESCLAVO;
    }

    /*
     * ⛔ LA EXCEPCIÓN: el bit 7 del fcode encendido.
     *
     * Esto es lo que el AVR no mira, y por eso **decodifica el código de error
     * como si fuera el dato**. Una excepción tiene CRC válido y 5 bytes de
     * largo: pasa todos los chequeos que aquel hace.
     */
    if( pucRx[ 1 ] == ( uint8_t ) ( ucFcode | 0x80U ) )
    {
        ucExcepcion = pucRx[ 2 ];
        return mbEXCEPCION;
    }

    if( pucRx[ 1 ] != ucFcode )
    {
        return mbOTRO_FCODE;
    }

    return mbOK;
}
//------------------------------------------------------------------------------
mb_result_t drv_modbus_leer( uint8_t ucSla, uint8_t ucFcode, uint16_t usReg,
                             uint8_t ucNroRegs,
                             uint8_t *pucPayload, uint8_t *pucLargo )
{
    if( pucLargo != NULL )
    {
        *pucLargo = 0U;
    }

    if( ( pucPayload == NULL ) ||
        ( ucNroRegs == 0U ) || ( ucNroRegs > DRV_MODBUS_MAX_REGS ) ||
        ( ( ucFcode != 3U ) && ( ucFcode != 4U ) ) )
    {
        return mbPARAMETRO;
    }

    if( !drv_rs485_power_estado( rs485RAIL_BUS ) )
    {
        return mbBUS_APAGADO;
    }

    ucExcepcion = 0U;

    pucTx[ 0 ] = ucSla;
    pucTx[ 1 ] = ucFcode;
    pucTx[ 2 ] = ( uint8_t ) ( ( usReg & 0xFF00U ) >> 8 );
    pucTx[ 3 ] = ( uint8_t ) ( usReg & 0x00FFU );
    pucTx[ 4 ] = 0x00U;                 /* cantidad de registros, HIGH */
    pucTx[ 5 ] = ucNroRegs;             /* ...y LOW                    */

    int16_t     sLeidos = prvTransaccion( 6U, ( uint8_t ) ( 5U + ( 2U * ucNroRegs ) ) );
    mb_result_t eRes    = prvValidar( sLeidos, ucSla, ucFcode );

    if( eRes != mbOK )
    {
        return eRes;
    }

    /*
     * El byte 2 es el *byte count*, y **tiene que coincidir con lo que pedimos**.
     * Si no coincide, la trama es sintácticamente válida pero responde a otra
     * cosa; copiar igual sería leer bytes que nadie prometió.
     */
    uint8_t ucCount = pucRx[ 2 ];

    if( ( ucCount != ( uint8_t ) ( 2U * ucNroRegs ) ) ||
        ( ( uint16_t ) ucCount + 5U > ( uint16_t ) sLeidos ) )
    {
        return mbLARGO_INESPERADO;
    }

    memcpy( pucPayload, &pucRx[ 3 ], ucCount );

    if( pucLargo != NULL )
    {
        *pucLargo = ucCount;
    }

    return mbOK;
}
//------------------------------------------------------------------------------
mb_result_t drv_modbus_escribir( uint8_t ucSla, uint16_t usReg, uint16_t usValor,
                                 uint16_t *pusRespuesta )
{
    if( pusRespuesta != NULL )
    {
        *pusRespuesta = 0U;
    }

    if( !drv_rs485_power_estado( rs485RAIL_BUS ) )
    {
        return mbBUS_APAGADO;
    }

    ucExcepcion = 0U;

    pucTx[ 0 ] = ucSla;
    pucTx[ 1 ] = 6U;
    pucTx[ 2 ] = ( uint8_t ) ( ( usReg & 0xFF00U ) >> 8 );
    pucTx[ 3 ] = ( uint8_t ) ( usReg & 0x00FFU );
    pucTx[ 4 ] = ( uint8_t ) ( ( usValor & 0xFF00U ) >> 8 );
    pucTx[ 5 ] = ( uint8_t ) ( usValor & 0x00FFU );

    int16_t     sLeidos = prvTransaccion( 6U, 8U );   /* el eco del 06 son 8 bytes */
    mb_result_t eRes    = prvValidar( sLeidos, ucSla, 6U );

    if( eRes != mbOK )
    {
        return eRes;
    }

    /*
     * ⚠ Se verifica **la dirección del registro**, que sí es eco, y NO el valor.
     *
     * El control de presión de Spymovil devuelve **su registro de status** en el
     * lugar del valor escrito: se ve en `modbus_slave_process_frame06()` de su
     * firmware (`tx_buffer[5] = systemVars.status_register`) y en sus propias
     * capturas —a un pedido de `05` contesta `01`—. Exigir el eco del valor lo
     * rechazaría siempre, y con eso la consigna **nunca podría funcionar**.
     *
     * Lo que sí se verifica sigue teniendo valor: que conteste sobre otro
     * registro significa que no entendió el pedido.
     */
    if( ( sLeidos < 8 ) ||
        ( pucRx[ 2 ] != pucTx[ 2 ] ) || ( pucRx[ 3 ] != pucTx[ 3 ] ) )
    {
        return mbLARGO_INESPERADO;
    }

    if( pusRespuesta != NULL )
    {
        *pusRespuesta = ( ( uint16_t ) pucRx[ 4 ] << 8 ) | pucRx[ 5 ];
    }

    return mbOK;
}
//------------------------------------------------------------------------------
