ppeluffo/FWDLGARM_R1/Application/drivers/drv_rtc79410.h

/*
 * drv_rtc79410.h
 *
 * RTC externo **MCP79410** en el bus I2C2, dirección de dispositivo `0xDE`.
 *
 * Es el mismo integrado que usaba FWDLGX en el AVR, así que la estructura de
 * tiempo se conserva byte a byte (`RtcTimeType_t`) para que el código de
 * aplicación heredado se porte sin tocarlo. Lo que cambia es lo de abajo: allá
 * eran registros del AVR, acá es `drv_i2c` sobre la HAL.
 *
 * El chip aparece DOS veces en el bus, y no es un error:
 *   `0xDE` (7 bits: 6f) -> reloj, SRAM de 64 bytes, alarmas
 *   `0xAE` (7 bits: 57) -> una EEPROM propia de 128 bytes y el número de serie
 * Este driver habla con el primero.
 *
 * ---------------------------------------------------------------------------
 * TODO EN BCD
 *
 * Los registros no son binarios: las 25 son 0x25, no 0x19. Un `hora + 1` sobre el
 * valor crudo da 0x26, que en BCD son las 26 — una hora que no existe. La
 * conversión se hace acá adentro y hacia afuera todo es binario común.
 *
 * ---------------------------------------------------------------------------
 * LOS TRES BITS QUE HAY QUE MIRAR SÍ O SÍ
 *
 * Viven en el registro RTCWKDAY (0x03), mezclados con el día de la semana:
 *
 *   OSCRUN  (bit 5, sólo lectura) 1 = el cristal está oscilando. Si es 0, el
 *           reloj NO está contando y la hora que devuelva es basura congelada.
 *   PWRFAIL (bit 4) 1 = se cortó la alimentación principal en algún momento. El
 *           chip guarda ADEMÁS la marca de tiempo de cuándo se cayó y cuándo
 *           volvió, en 0x18..0x1F. Es información de campo, no sólo de banco.
 *           ⚠ Ver más abajo: esas marcas son un LATCH, no un registro rodante.
 *   VBATEN  (bit 3) 1 = habilitado el respaldo por pila. **Viene en 0 de
 *           fábrica**: si nadie lo pone en 1, el chip pierde la hora al cortar
 *           la alimentación aunque la pila esté soldada. Lo pone drv_rtc_init().
 *
 * Y el ST (bit 7 de RTCSEC, 0x00): el oscilador arranca detenido de fábrica. Hay
 * que ponerlo en 1 una vez. También lo hace drv_rtc_init().
 */

#ifndef APPLICATION_DRIVERS_DRV_RTC79410_H_
#define APPLICATION_DRIVERS_DRV_RTC79410_H_

#include <stdbool.h>
#include <stdint.h>

/* Misma estructura que FWDLGX, mismos campos y mismo orden. Todo en BINARIO:
   la conversión desde y hacia BCD es interna al driver.
   `year` son los dos últimos dígitos (0..99); el chip no tiene siglo. */
typedef struct {
    uint8_t sec;        /* 0..59 */
    uint8_t min;        /* 0..59 */
    uint8_t hour;       /* 0..23 - siempre 24 horas, el driver fuerza el modo */
    uint8_t weekDay;    /* 1=dom .. 7=sab. DE SALIDA: al escribir se ignora     */
    uint8_t day;        /* 1..31 */
    uint8_t month;      /* 1..12 */
    uint8_t year;       /* 0..99 */
} RtcTimeType_t;

/*
 * Día de la semana a partir de la fecha (algoritmo de Sakamoto). 1=dom .. 7=sab.
 *
 * Existe porque el MCP79410 **no lo calcula**: sólo cuenta de 1 a 7 y da la
 * vuelta, así que un valor mal cargado queda mal para siempre y nadie lo nota
 * hasta que algo lo usa. Es un dato DERIVADO de la fecha, y pedirlo a mano es
 * pedir que alguien se equivoque — pasó en banco el 2026-08-12, con un miércoles
 * cargado como domingo.
 */
uint8_t drv_rtc_dia_de_semana( uint8_t ucAnio2, uint8_t ucMes, uint8_t ucDia );

/* Estado del chip, para diagnóstico y para decidir si la hora sirve. */
typedef struct {
    bool bOscilando;    /* OSCRUN  */
    bool bFalloPower;   /* PWRFAIL */
    bool bPilaHab;      /* VBATEN  */
} rtc_estado_t;

/*
 * Arranca el oscilador si está detenido, habilita el respaldo por pila y fuerza
 * el modo de 24 horas. Es idempotente: si ya está todo bien, no escribe nada.
 *
 * Devuelve false si el chip no contesta. Que devuelva true NO garantiza que la
 * hora sea válida — para eso está drv_rtc_estado().
 */
bool drv_rtc_init( void );

bool drv_rtc_estado( rtc_estado_t *pxEstado );

/*
 * Lee la fecha y hora.
 *
 * Lee DOS VECES y compara los segundos: si el reloj avanza justo entre el byte
 * de los minutos y el de las horas, quedaría una hora imposible (las 10:59:59
 * leídas como las 11:59:59). Es un error de una vez por hora, silencioso, y
 * carísimo de encontrar en los datos meses después.
 */
bool drv_rtc_leer( RtcTimeType_t *pxHora );

/*
 * Fija la fecha y hora, siguiendo la secuencia que pide el datasheet: parar el
 * oscilador, escribir, arrancarlo de nuevo. Escribir los registros con el reloj
 * corriendo puede caer justo en un acarreo y dejar la hora corrida.
 *
 * ⚠ `pxHora->weekDay` SE IGNORA: se calcula de la fecha con
 * drv_rtc_dia_de_semana(). Ver el porqué ahí.
 *
 * Al terminar deja la firma de validez en la SRAM (ver más abajo).
 */
bool drv_rtc_escribir( const RtcTimeType_t *pxHora );

/*
 * Marca de tiempo del corte de alimentación. `bCaida` elige entre cuándo se cayó
 * y cuándo volvió. El chip no guarda ni segundos ni año en estos registros.
 *
 * ⚠ ES UN LATCH, NO UN REGISTRO RODANTE — y confunde, porque parece lo segundo.
 *
 * El chip graba el PRIMER corte y ahí se congela: mientras PWRFAIL siga en 1,
 * los cortes posteriores NO pisan las marcas. Recién vuelve a grabar cuando
 * alguien baja PWRFAIL. Verificado en banco el 2026-08-12: dos cortes seguidos
 * sin limpiar en el medio, y las marcas seguían mostrando el primero.
 *
 * Consecuencia para la aplicación, y no es menor: **al arrancar hay que leer las
 * marcas, guardarlas donde corresponda, y recién ahí limpiar PWRFAIL.** Si no se
 * limpia nunca, en campo se termina viendo para siempre el primer corte de la
 * vida del equipo y ninguno de los que importan. Si se limpia sin leer antes, se
 * tira la evidencia.
 *
 * drv_rtc_init() NO limpia a propósito: descartar evidencia en silencio, al
 * arrancar, sería lo peor de los dos mundos.
 */
bool drv_rtc_leer_falla_power( bool bCaida, RtcTimeType_t *pxHora );

/* Baja PWRFAIL y borra las marcas, habilitando al chip a grabar el próximo corte.
   Leer ANTES: esto es destructivo. */
bool drv_rtc_limpiar_falla_power( void );

/*==============================================================================
 * ¿SE PUEDE CREER LA HORA?
 *
 * La pregunta no es retórica: el 2026-08-12, en cuatro cortes de alimentación
 * seguidos, el respaldo aguantó tres y falló uno. En campo esto va a pasar —una
 * pila se agota, un contacto se afloja— y **un datalogger que estampa
 * `2001-01-01` en las muestras sin marcarlas es peor que uno que no estampa
 * nada**: los datos malos se mezclan con los buenos y no hay forma de separarlos
 * después.
 *
 * Adivinar por la fecha es frágil (¿qué año es "demasiado viejo"?). El mecanismo
 * bueno es una FIRMA en la SRAM del propio MCP79410, y funciona porque **la SRAM
 * y el contador de tiempo se alimentan de la misma pila**:
 *
 *     firma intacta  <=>  el respaldo sostuvo  <=>  el reloj nunca se detuvo
 *     firma perdida  <=>  el respaldo falló    <=>  el chip arrancó frío
 *
 * No hay caso intermedio, y esa es toda la gracia: no es una heurística, es una
 * equivalencia física. Si algún día la hora se guardara en un lado y la firma en
 * otro con alimentaciones distintas, el mecanismo dejaría de valer.
 *
 * La firma la escribe drv_rtc_escribir(): fijar la hora es exactamente el
 * momento en que alguien afirma que es correcta.
 *============================================================================*/
typedef enum {
    rtcHORA_VALIDA = 0,     /* la firma está: el reloj no se interrumpió       */
    rtcHORA_ARRANQUE_FRIO,  /* la firma no está: se perdió el respaldo         */
    rtcHORA_SIN_RTC         /* el chip no contesta                             */
} rtc_validez_t;

rtc_validez_t drv_rtc_validez( void );

/* Borra la firma. Es para PROBAR el mecanismo en banco sin tener que sacar la
   pila: deja al equipo exactamente como si hubiera arrancado frío. */
bool drv_rtc_invalidar( void );

/*------------------------------------------------------------------------------
 * SRAM de 64 bytes respaldada por la pila, direcciones 0x00..0x3F.
 *
 * Los primeros DRV_RTC_SRAM_USUARIO bytes son de la firma y el driver **rechaza
 * escribirlos** desde acá; leerlos sí se puede, para diagnóstico. La aplicación
 * empieza en DRV_RTC_SRAM_USUARIO.
 *----------------------------------------------------------------------------*/
#define DRV_RTC_SRAM_SIZE       64U
#define DRV_RTC_SRAM_USUARIO     5U   /* 4 de magia + 1 de versión */

/*------------------------------------------------------------------------------
 * ⚠ EL MAPA DE LA SRAM, que estaba repartido en tres archivos
 *
 * Son 64 bytes y **no hay ningún mecanismo que impida que dos módulos se pisen**:
 * cada uno define su dirección con un `#define` en su propio `.c`. Antes de
 * agregar algo, mirar acá — un solapamiento se manifestaría como una FAT
 * corrupta o un contador de lotes que salta, o sea acusando al componente
 * equivocado, que es el modo de falla más caro de este proyecto.
 *
 * | Dirección | Tamaño | Quién | Definido en |
 * |---|---|---|---|
 * | `0..4`   | 5  | la **firma** de validez de la hora | este driver |
 * | `5..14`  | 10 | la **FAT** del almacén (`fs_fat_t`) | `fs_datos.c` |
 * | `21..24` | 4  | el **contador de lotes** de la microSD | `fs_sd.c` |
 * | `32..39` | 8  | la **marca de la última sincronización** de hora | `tkCmd.c` |
 * | `40..63` | 24 | libre |
 *----------------------------------------------------------------------------*/

int16_t drv_rtc_sram_leer   ( uint8_t ucAddr, char *pvBuffer, uint8_t ucBytes );
int16_t drv_rtc_sram_escribir( uint8_t ucAddr, const char *pvBuffer, uint8_t ucBytes );

#endif /* APPLICATION_DRIVERS_DRV_RTC79410_H_ */
