ppeluffo/FWDLGARM_R1/Application/drivers/drv_ina3221.c

/*
 * drv_ina3221.c  -  ver drv_ina3221.h
 */

#include "drv_ina3221.h"
#include "drv_i2c.h"
#include "main.h"

#define TRANSACCION_TIMEOUT_MS  250U

/* Los registros de shunt y de bus del canal N son consecutivos y arrancan en 0x01,
   dos por canal: CH1 en 0x01/0x02, CH2 en 0x03/0x04, CH3 en 0x05/0x06. */
#define REG_SHV( ch )   ( ( uint8_t ) ( DRV_INA_REG_CH1_SHV  + ( 2U * ( ch ) ) ) )
#define REG_BUSV( ch )  ( ( uint8_t ) ( DRV_INA_REG_CH1_BUSV + ( 2U * ( ch ) ) ) )

static bool bPresente = false;
static bool bRielOn   = false;

/*------------------------------------------------------------------------------
 * Las 13 cuentas con signo que hay en `[15:3]`.
 *
 * El corrimiento se hace sobre un int16_t para que el compilador propague el bit
 * de signo: `>>` sobre un tipo con signo es aritmético en GCC. Un valor negativo
 * significa que la corriente circula al revés de lo previsto —lazo abierto, shunt
 * mal cableado— y hay que poder verlo como negativo, no como 8000 y pico.
 *----------------------------------------------------------------------------*/
static int16_t prvCuentas13( uint16_t usReg )
{
    return ( int16_t ) ( ( ( int16_t ) usReg ) >> 3 );
}
//------------------------------------------------------------------------------
bool drv_ina_reg_leer( uint8_t ucReg, uint16_t *pusVal )
{
    char pcDatos[ 2 ] = { 0 };

    if( drv_i2c_read( DRV_I2C_ADDR_INA, ( uint16_t ) ucReg, 1U,
                      pcDatos, 2U,
                      pdMS_TO_TICKS( TRANSACCION_TIMEOUT_MS ) ) != 2 )
    {
        return false;
    }

    /* Big endian: el MSB primero. */
    *pusVal = ( uint16_t ) ( ( ( uint16_t ) ( uint8_t ) pcDatos[ 0 ] ) << 8 ) |
              ( uint16_t ) ( ( uint8_t ) pcDatos[ 1 ] );

    return true;
}
//------------------------------------------------------------------------------
bool drv_ina_reg_escribir( uint8_t ucReg, uint16_t usVal )
{
    char pcDatos[ 2 ];

    pcDatos[ 0 ] = ( char ) ( ( usVal >> 8 ) & 0xFFU );
    pcDatos[ 1 ] = ( char ) ( usVal & 0xFFU );

    return ( drv_i2c_write( DRV_I2C_ADDR_INA, ( uint16_t ) ucReg, 1U,
                            pcDatos, 2U,
                            pdMS_TO_TICKS( TRANSACCION_TIMEOUT_MS ) ) == 2 );
}
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
