ppeluffo/FWDLGARM_R1/(commit log)

2026-08-10 Firmware inicial: clock MSI y LED parpadeando
    Primer punto conocido-bueno del bring-up de la placa R001, validado en banco.
    - Proyecto CubeMX para STM32L496RGT6, sin FreeRTOS ni periféricos.
    - Clock: MSI range 6 (4 MHz) -> PLL M=1 N=30 /2 -> 60 MHz, FLASH_LATENCY_3,
    voltage scale 1. Sin dependencia del cristal de 32.768 kHz.
    - GPIO: LED en PB9 (parpadea a 0,5 Hz) y LED2 en PA2 (configurado, sin usar).
    - El .ioc declara sólo NVIC, RCC y SYS.
    El LSE queda deshabilitado a propósito: se avanza con el clock interno y el
    cristal se aborda en una etapa posterior, junto con el tick por LPTIM1.
    Claude-Session: https://claude.ai/code/sessio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
2026-08-10 Incorporar CLAUDE.md al repo del firmware
    Estaba en SPQ_ARM/, fuera de todo control de versiones. Moverlo acá lo hace
    viajar con el código y quedar versionado junto a la etapa que describe.
    Se agrega una nota de orientación: las rutas del documento siguen siendo
    relativas a SPQ_ARM/ (dos niveles arriba), salvo Core/, Drivers/ y Debug/,
    que son de este repo.
    Claude-Session: https://claude.ai/code/session_01KocZ9c35Pwi7BgBAdxRGP4
2026-08-10 FreeRTOS desde CubeMX, con la aplicación en API nativa
    Segunda etapa del bring-up, validada en banco: la tarea tkCtl hace parpadear
    el LED bajo el scheduler.
    Configuración generada por CubeMX:
    - Middlewares FreeRTOS, port GCC/ARM_CM4F (este micro tiene FPU) y heap_4.
    - Timebase de la HAL movido a TIM6: el SysTick pasa a ser del kernel, así que
    sin este paso el primer HAL_Delay() colgaría.
    - Interface CMSIS-RTOS v2. CubeMX no ofrece una opción sin wrapper, pero el
    kernel es el mismo y osKernelStart() sólo llama a vTaskStartScheduler(), así
    que toda la aplicación se escribe con la API nativa.
    Aplicación:
    - tkCtl (Core/Src/FWDLGARM_R1_tkCtl.c) creada con xTaskCreateStatic: stac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
2026-08-10 Corregir la nota del programador: el firmware arranca solo
    Quedó documentado que el ciclo de alimentación era inherente al dongle. Es
    falso: programando desde la GUI de CubeIDE/CubeProgrammer el micro arranca al
    terminar el download.
    El tramo en que sí hizo falta cortar la alimentación era consecuencia del
    estado en que dejaban el dongle las herramientas de línea de comandos, sobre
    todo OpenOCD, que deja NRST asertado. Se deja anotado cómo destrabarlo por si
    el síntoma reaparece.
    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
2026-08-10 Cristal externo de 32.768 kHz: LSE andando y RTC activado
    Tercera etapa del bring-up, validada en banco. El LSE arranca y alimenta al RTC.
    La clave estuvo en activar el RTC como periférico, no sólo en asignar los pines
    y poner el mux en LSE. Asignar PC14/PC15 como OSC32_IN/OUT y dejar el RTC/LCD
    Source Mux en LSE NO alcanza: CubeMX genera el encendido del LSE sólo si algún
    periférico lo consume de verdad, o sea si figura en Mcu.IPx. Con el RTC sin
    activar, SystemClock_Config() seguía trayendo únicamente MSI.
    Ahora sí queda la cadena completa:
    - .ioc: Mcu.IP3=RTC
    - SystemClock_Config(): RCC_OSCILLATORTYPE_LSE|MSI con LSEState = RCC_LSE_ON
    - HAL_RTC_MspInit(): RTCClockSelection = RCC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
2026-08-10 Documentar el LSE andando y reordenar el roadmap
    El CLAUDE.md seguía diciendo que el LSE estaba deshabilitado a propósito y que
    el clock interno alcanzaba, cuando el cristal ya está validado en v0.0.3.
    - Estado actual: tabla de las tres etapas etiquetadas, cadena completa del LSE
    (Mcu.IP3=RTC, RCC_OSCILLATORTYPE_LSE, mux en HAL_RTC_MspInit) y advertencia
    sobre el LSE Drive en LOW, que anda pero es el de menor margen de arranque.
    - La sección de la trampa de CubeMX pasa de "a evitar" a "resuelta", con la
    pieza que faltaba —activar el RTC como periférico— y el estado de referencia
    que queda cuando se hace bien.
    - Notas de bring-up: se agrega la fórmula de la carga del crista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
2026-08-11 Tick de FreeRTOS por LPTIM1 desde el LSE, a 512 Hz exactos
    El tick del kernel deja el SysTick y pasa al LPTIM1, que se alimenta del
    cristal de 32.768 kHz y sigue vivo en los modos Stop. Es el requisito para
    el tickless de bajo consumo, que viene en el paso siguiente.
    La cuenta: LSE 32768 / prescaler 32 = 1024 Hz de contador, y ARR = 1 da 2
    cuentas por tick -> 512 Hz sin error de redondeo ni deriva acumulada.
    El tick es de 512 Hz y no de 1000 porque 1000 no divide a 32768: el tick
    real quedaria en 992,97 Hz, un sesgo permanente de +0,71 % (~10 min/dia) y
    ademas obligaria al prescaler /1, que baja el techo de sueno de 64 s a 2 s.
    Tampoco es de 1024, que era la primera eleccion, porque CubeMX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
    [FWDLGARM_R1.ioc, FWDLGARM_R1_lptim_tick.c, main.c, main.h]
2026-08-11 Tickless con Stop 2: el consumo de placa baja de 3,2 mA a 0,215 mA
    vPortSuppressTicksAndSleep() pisa la weak que genera CubeMX en freertos.c.
    Reprograma el LPTIM1 para que la proxima IRQ caiga al final del sueno, entra
    en Stop 2, y al despertar le informa al kernel el tiempo dormido con
    vTaskStepTick(). Techo de 64 s por sueno (contador de 16 bits a 1024 Hz) y
    piso de 3 ticks, por debajo del cual no compensa el costo fijo del ciclo.
    Detalles que resolvio la implementacion:
    - Al salir de Stop hay que rellamar a SystemClock_Config() ANTES de tocar
    nada del HAL, porque Stop apaga el PLL y sus timeouts se calculan con
    SystemCoreClock.
    - TIM6, el timebase de la HAL, interrumpe a 1 kHz y anu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
2026-08-11 Consola TERM sobre FRTOS-IO, y el codigo propio pasa a Application/
    PENDIENTE DE VALIDAR EN BANCO: compila y linkea (Debug y Release), pero
    todavia no se probo la consola contra una terminal real. Por eso no lleva
    tag; el tag v0.0.6 va cuando este validado.
    Se porta la arquitectura de FWDLGX: capa de drivers abajo, FRTOS-IO encima
    dando frtos_open/read/write/ioctl por file descriptor, y frtos_cmd con el
    ciclo de comandos. Misma API que el codigo heredado -mismos nombres, mismos
    codigos de ioctl, mismo int16_t con -1 en error- reimplementada sobre la HAL.
    Cambios de fondo respecto del codigo AVR/SAM4L, todos con motivo:
    - Despacho por TABLA con vtable en vez de frtos_{read,write,ioctl}_uar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
    [FWDLGARM_R1.ioc, drv_term_sense.c, drv_term_sense.h, drv_uart.c, drv_uart.h, frtos-io.c, frtos-io.h, frtos_cmd.c]
2026-08-11 Anotar el diseño pendiente de microSD + FatFs (paso 6)
    Relevamiento previo a escribir código, para llegar al paso 6 con las decisiones
    tomadas. No se escribe nada todavía: la microSD no está poblada.
    Lo averiguado:
    - CubeMX trae FatFs de ChaN R0.12c (rev 68300), pero sólo la mitad de arriba.
    Los diskio que provee ST son SDMMC/SDRAM/SRAM/USB/PPP: no hay ninguno de SD
    por SPI, y los cuatro ejemplos del paquete L4 son uSD por SDMMC. Con SPI3 hay
    que ir por "User-defined" y escribir user_diskio.c entero. O sea que lo que
    se rehace es el driver de tarjeta, no el filesystem.
    - FreeRTOS: option/syscall.c habla CMSIS-RTOS; _FS_TIMEOUT está en ticks (1000
    = 1,95 s con el tick a 512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
2026-08-11 Banco: aislar la TX de la TERM por capas, sin tickless ni TERM_SENSE
    La consola no dio señales de vida en el primer flasheo (el LED de tkCtl seguía
    destellando, o sea que el kernel andaba y nada se colgó). Para bisecar, se
    reemplaza temporalmente tkCmd por una prueba que manda una línea por segundo
    por tres caminos, cada uno agregando una capa:
    1) literal const + HAL_UART_Transmit por poleo -> pines/AF7/baudios/transceiver
    2) idem, armando la línea con snprintf -> agrega newlib y su stack
    3) xprintf -> frtos_write -> Transmit_IT -> agrega el camino por ISR
    Cuál es la última que sale dice dónde está el corte. La capa 2 está separada de
    la 1 a propósito: con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
2026-08-11 TX de la TERM validada (era el cable); el banco pasa a probar RX
    Etapa 1 cerrada: salieron las tres capas del modo banco, o sea que la TX está
    validada de punta a punta — pines/AF7/baudios/transceiver, newlib sin desbordar
    el stack de tkCmd, y el camino por interrupción completo (Transmit_IT,
    TxCpltCallback dando el semáforo, mutex de xprintf, tabla de FRTOS-IO). El
    contador iba por 277 ciclos sin perder el semáforo, que era la falla
    intermitente que se temía.
    La causa del silencio era el cable del puerto serial. Las tres hipótesis de
    firmware —MSI descalibrado, desborde de stack, semáforo de TX perdido— eran
    razonables y ninguna era. Queda anotado en el archivo.
    Etapa 2: el b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
2026-08-11 Migas de pan en el arranque de tkCmd, y sacar el taskYIELD del lazo de RX
    Síntoma nuevo: no sale ni el mensaje de arranque y el LED queda fijo, o sea que
    se cuelga ANTES del banner. Con el LED quieto tampoco sirve como testigo de vida,
    así que hay que instrumentar el prólogo en vez de adivinar.
    Se emite una letra por HAL cruda al superar cada etapa: [A] la tarea arrancó y la
    TX anda, [B] pasó el DisableIRQ del EXTI, [C] frtos_open_all() volvió bien, [D]
    el Receive_IT quedó abortado. La última letra que aparezca ubica el cuelgue sin
    debugger. Si no sale ni [A], el sospechoso es el NRST trabado documentado en
    CLAUDE.md, no este código.
    Además se cambia taskYIELD() por vTaskDelay(1)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
2026-08-11 RX crudo validado; el banco pasa al camino por ISR. SWD a 950 kHz
    Con el SWD bajado a 950 kHz el flasheo volvió a andar, y el eco por poleo dio
    bien: 'qwertpablo' devolvió 0x71 0x77 0x65 0x72 0x74 0x70 0x61 0x62 0x6C 0x6F,
    sin un solo ERR FE/NE. O sea que PB7, el AF7, el cable en ese sentido y el
    muestreo del USART están validados, y de paso queda confirmado que el reloj está
    bien — un error de baudios habría dado FE o NE.
    Se pasa TKCMD_BANCO_RX_CRUDO a 0: queda por probar lo único que nunca corrió,
    ISR -> RxCpltCallback -> xStreamBufferSendFromISR -> frtos_read desbloqueándose.
    Dos cosas nuevas en CLAUDE.md, sección del programador:
    - Punto 4: la frecuencia SWD tiene que estar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
    [tkCmd.c]
2026-08-11 RX por ISR validado: vuelve la consola de verdad
    El eco por el camino real pasó — ISR -> RxCpltCallback ->
    xStreamBufferSendFromISR -> frtos_read desbloqueándose. La prueba que valió fue
    pegar 46 caracteres de un saque: todos llegaron en orden y sin un solo ERR ORE,
    o sea que el rearme del Receive_IT dentro del callback aguanta el ritmo y el
    stream buffer no se desborda.
    Con eso la TERM queda probada de punta a punta en las dos direcciones, así que
    TKCMD_MODO_BANCO pasa a 0 y tkCmd vuelve a ser la consola: FRTOS_CMD, los
    comandos help/status/reset, el decodificador VT100 y drv_term_sense_init().
    El andamio del banco NO se borra. Queda compilado fuera, con las dos etapas
    anotadas y lo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
    [tkCmd.c]
2026-08-11 Informar la causa del último reset en el banner y en status
    El comando reset deja el LED fijo y no se sabe si el micro llega a rearrancar.
    Se lee RCC_CSR al arrancar tkCmd, antes que nada, y se limpia con RMVF: las
    banderas son acumulativas y sin limpiarlas cada arranque informaría la causa de
    todos los anteriores juntos.
    Si después de "reset" aparece el banner con SOFT, el micro rearrancó y el LED
    fijo es otra cosa. Si no aparece nada, no rearrancó.
    No es sólo instrumental de banco: en un datalogger a batería, distinguir un
    reboot por IWDG de uno por BOR (batería floja) o por software es información de
    campo, así que queda permanente. Se muestra también en status.
    Co-Authored-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
    [tkCmd.c]
2026-08-11 Migas de pan en el arranque de main(), para ubicar el cuelgue del 2do reset
    Dato nuevo: el primer "reset" por consola rearranca bien (el banner informa
    "SOFT PIN", así que el micro sí rearranca y NVIC_SystemReset tambien asierta
    NRST), pero el segundo cuelga con el LED fijo. Pasa con y sin ST-LINK, así que
    el dongle queda descartado — no es el NRST trabado documentado en CLAUDE.md.
    Lo que sobrevive a un reset por software es el dominio de backup: LSE, RTC y
    RCC_BDCR. O sea que los sospechosos son MX_RTC_Init() y MX_LPTIM1_Init(), que
    corren ANTES de que la USART esté inicializada — sin instrumentar no hay forma
    de verlo salvo con debugger.
    Se adelanta MX_USART1_UART_Init() a USER C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
    [main.c]
2026-08-11 Comando 'reboot': reinicio tibio sin NRST, para aislar el cuelgue del reset
    Realidad confirmada: cada 'reset' deja la placa muerta hasta que se le corta la
    alimentación, y cuando llega a rearrancar informa BOR/POR — o sea que el riel se
    cayó por debajo del umbral de brown-out.
    Que sólo se recupere con un ciclo de alimentación es el dato que manda. Si fuera
    el micro colgado, un reset por NRST lo sacaría; si fuera el ST-LINK reteniendo
    NRST, un ciclo de alimentación NO lo arreglaría (esa es la firma de OpenOCD, ya
    documentada). Queda que la fuente se traba apagada.
    Hipótesis principal: NVIC_SystemReset() hace que el micro maneje NRST como
    salida y lo tire a masa, y en el L496 eso n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
    [tkCmd.c]
2026-08-11 Hacer hablar a Error_Handler, y adelantar la USART antes del clock
    Corrección de lectura: el "reset por BOR/POR" NO era consecuencia del comando
    reset, era el arranque después del ciclo de alimentación que hace Pablo para
    recuperar la placa. Un ciclo de energía reporta BOR/POR y eso es correcto. O sea
    que el riel nunca se cayó solo y la teoría del regulador que se traba queda
    descartada. NRST, además, sólo va al conector del programador.
    Lo que sí dice el log: después de "reiniciando..." no aparece NINGUNA miga, ni
    [1] — que se emite justo después de SystemClock_Config(). El cuelgue está en
    HAL_Init() o en SystemClock_Config(), antes que todo lo demás. Y
    SystemClock_Config()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
    [main.c]
2026-08-11 Bajar RMVF después de subirlo, e informar el caso "sin reset de hardware"
    Bug propio, visible en la última corrida: después de un 'reboot' el banner
    imprimía "reset por :" vacío. La causa no era sólo que un salto en caliente no
    genere banderas — es que RMVF no es autolimpiante en el L4, y
    __HAL_RCC_CLEAR_RESET_FLAGS() sólo hace SET_BIT. Mientras el bit queda en 1 las
    banderas se mantienen borradas, así que el arranque siguiente informaría
    "ninguno" aunque hubiera habido un reset de verdad.
    Se salvó de pasar desapercibido de casualidad: un reset de hardware resetea
    RCC_CSR y de paso bajaba RMVF. Recién con 'reboot', que no resetea nada, quedó
    expuesto. Ahora se baja explíci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
    [tkCmd.c]
2026-08-11 Documentar por qué el Error_Handler parecía un LED fijo
    Con el tick en LPTIM1 el SysTick no se arranca nunca, así que error_delay_ms()
    usa siempre el lazo tosco calibrado por SystemCoreClock. Si Error_Handler() se
    dispara desde adentro de SystemClock_Config(), esa variable todavía vale 4 MHz en
    vez de 60: los destellos salen quince veces más rápidos y el patrón de 2
    parpadeos se vuelve un parpadeo tan veloz que a ojo parece un LED prendido fijo.
    Se confundió con un cuelgue mudo más de una vez en el día, así que va a CLAUDE.md
    junto con las dos correcciones: SystemCoreClockUpdate() al entrar al handler, y
    la USART levantada antes de SystemClock_Config() para que además lo diga po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
2026-08-12 Sacar las migas de pan del arranque, y dejar el canal crudo que sí sirve
    TX y RX de la TERM quedaron validados de punta a punta, así que las migas
    [0]..[7] ya cumplieron: se sacan las ocho.
    Lo que NO se saca, porque se ganó su lugar:
    - La USART adelantada a USER CODE BEGIN Init, antes de SystemClock_Config().
    Es lo que permite que una falla de RELOJ se diga por texto en vez de por
    destellos de un LED que además miente (SystemCoreClock viejo -> patrón 15
    veces más rápido, que a ojo parece un LED fijo).
    - La reinicialización en SysInit, que recalcula el divisor contra los 60 MHz.
    Sin ella todo lo que emitieran los MX_*_Init() saldría ilegible.
    - La función de emisión cruda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
2026-08-12 Comando 'sense': ver el nivel de TERM_SENSE y si la EXTI dispara
    El pin lee "ausente" con la terminal enchufada. Desde afuera eso tiene tres
    causas que se ven iguales, así que el comando las separa en una sola pasada:
    el nivel NUNCA baja -> hardware (pull-up interno y nadie que tire
    a masa: sin poblar, o sin llegar al conector)
    baja pero eventos EXTI = 0 -> configuración de la interrupción
    baja, hay eventos, y el
    driver sigue diciendo ausente -> firmware, en prvActualizar()
    Imprime una foto —nivel, estado del driver, contador de EXTI, candado de
    energía, MODER/PUPDR, IMR/RTSR/FTSR y el enable del NVIC— y después monitorea
    20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
2026-08-12 Reponer el tickless: TERM_SENSE valida el mecanismo del candado
    El comando 'sense' mostró la cadena entera funcionando: el pin cambia de nivel
    al enchufar y desenchufar la terminal, la EXTI dispara, el driver sigue el
    estado y pwrLOCK_TERM se toma y se suelta con él.
    Eso era lo que faltaba para reponer el tickless con sentido. Con la terminal
    conectada el candado fuerza Sleep en vez de Stop 2, así que la USART conserva
    el reloj y la consola sigue recibiendo; sin terminal el micro baja a Stop 2 y
    el flanco de la EXTI es lo que lo despierta cuando alguien la enchufa.
    Se borra el #undef del bloque USER CODE de FreeRTOSConfig.h, que era el andamio
    del banco de la TERM. El .ioc siempre dijo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
2026-08-12 TERM_SENSE por poleo desde tkCtl, no por EXTI
    La EXTI resolvía un problema que no existe. El datalogger trabaja desatendido y
    la terminal es un caso excepcional de monitoreo: enterarse un segundo más tarde
    no le molesta a nadie. Es el esquema que ya usaba FWDLGX en el AVR.
    El argumento original a favor de la EXTI era que polear despierta al micro. Es
    falso acá: tkCtl YA despierta cada segundo para destellar el LED, así que leer
    un pin en esa vuelta no agrega ni una despertada.
    Y la EXTI no era neutra, costaba. El conector rebota —se midieron hasta 82
    interrupciones por un solo enchufe— y cada flanco despierta al micro de Stop 2
    y le hace rehacer SystemClock_Config(). Poco en absolu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
    [drv_term_sense.c, drv_term_sense.h, tkCmd.c, tkCtl.c]
2026-08-12 CubeMX: PB5 pasa a entrada simple, sin EXTI
    Regeneración desde el .ioc acompañando el cambio a poleo. Sale la línea EXTI de
    TERM_SENSE completa: GPIO_MODE_IT_RISING_FALLING -> GPIO_MODE_INPUT (el pull-up
    queda), el HAL_NVIC_SetPriority/EnableIRQ de EXTI9_5, el EXTI9_5_IRQHandler de
    stm32l4xx_it.c y el define TERM_SENSE_EXTI_IRQn de main.h.
    Con esto el conector ya no puede despertar al micro de Stop 2, que era el punto:
    el rebote del conector generaba hasta 82 interrupciones por enchufe.
    El resto del diff de main.c es CubeMX devolviéndole los CRLF nativos al archivo,
    que es como están el resto de los generados. Ruido, no cambio.
    De paso, el comentario de pwr_lock.c decía que TERM_SEN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
2026-08-12 CLAUDE.md: cerrar v0.0.6 — consola TERM, TERM_SENSE y bajo consumo
    Consumos medidos, con la fuente ya arreglada:
    dormido, sin terminal 65 uA (fuente sola en vacio: 60 uA)
    despierto, con terminal 3,5 mA (+1,5 mA del conector y el adaptador)
    O sea que el micro dormido consume ~5 uA. El numero se midio dos veces contra
    pisos distintos —los 210 uA de quiescent de la fuente vieja y los 60 de la
    nueva— y dio lo mismo las dos, asi que deja de ser "por debajo del piso del
    instrumento" y pasa a ser una medicion.
    Los 3,5 mA con la terminal enchufada no son una falla: son pwrLOCK_TERM
    bajando de Stop 2 a Sleep para que la USART conserve el reloj. El mecanismo
    quedo validado en l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
2026-08-12 Postergar a propósito la decisión sobre quién es el dueño de la hora
    MX_RTC_Init() reinicializa el reloj en cada arranque, pero no se arregla ahora:
    va a haber un MCP79410 externo en el I2C y probablemente sea él el dueño de la
    hora, porque tiene batería propia y VBAT no está poblado en R001.
    Quedan escritos los tres esquemas posibles para elegir cuando el bus ande, y la
    advertencia de no desactivar el RTC interno en CubeMX pase lo que pase: no
    cuesta nada y es el consumidor que destrabó el encendido del LSE en v0.0.3.
    Claude-Session: https://claude.ai/code/session_01Y6sRw6dH7sV6dnHhyp8Ds5
2026-08-12 Driver del bus I2C2, con fdI2C y el comando 'i2c' de la consola
    CubeMX quedó configurado por Pablo: I2C2 en PB13/PB14, AF4 open-drain sin pull
    interno (hay 10k externos), filtro analógico, NVIC EV/ER en prioridad 5, y
    Timing = 0x10A077A8, que contra los 60 MHz de PCLK1 da ~100 kHz reales.
    drv_i2c es el driver del BUS, no de los chips: mueve bytes entre una dirección
    de dispositivo y una dirección interna. Va por INTERRUPCIÓN con semáforo, mutex
    y candado pwrLOCK_I2C (nuevo). A 100 kHz, los 7 bytes de fecha y hora del RTC
    son ~900 us: pollear eso sería casi un milisegundo de CPU girando por lectura.
    Las direcciones van en formato de 8 bits (0xA0 la EEPROM, 0xDE el RTC), que es
    a la v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
2026-08-12 Driver de la EEPROM M24M01, y el candado de bus que necesita
    El escaneo mostró que la memoria es una M24M01 de 128 KB y no la M24M02 de 256
    que decía el comentario heredado de FWDLGX. La firma: contesta en 50 y 51, y su
    Identification Page en 58 y 59. Una M24M02 tendría que contestar en 50..53
    —A17/A16 los decodifica adentro, no son patas— así que dos bloques y no cuatro
    son 1 Mbit. Pablo lo confirmó contra el marcado del integrado.
    De ahí sale que la dirección es de 17 bits con A16 viajando DENTRO del byte de
    dispositivo (0xA0 / 0xA2). El driver expone una dirección plana 00000..1FFFF y
    esconde eso.
    Hallazgo del código viejo: eeprom.c de FWDLGX usa uint16_t y habla siempre a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
2026-08-12 Driver del RTC externo MCP79410
    Mismo integrado que usaba FWDLGX, así que RtcTimeType_t se conserva campo por
    campo para que el código de aplicación heredado se porte sin tocarlo. Lo que
    cambia es lo de abajo: allá eran registros del AVR, acá drv_i2c sobre la HAL.
    Los tres bits que definen si la hora sirve, y que no son obvios:
    - ST (RTCSEC bit 7): el oscilador viene DETENIDO de fábrica. Sin ponerlo en 1,
    el reloj no cuenta y devuelve basura congelada que parece una hora válida.
    - VBATEN (RTCWKDAY bit 3): el respaldo por pila viene DESHABILITADO de fábrica.
    Sin esto el chip pierde la hora al cortar la alimentación aunque la pila esté
    soldada — o sea, exactamente lo que fu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
2026-08-12 PWRFAIL es un latch, no un registro rodante
    Pablo cortó la alimentación dos veces seguidas y la segunda vez las marcas de
    tiempo seguían mostrando el primer corte. No es un bug del driver: el MCP79410
    graba el primer corte y se congela, y mientras PWRFAIL siga en 1 los cortes
    posteriores NO pisan las marcas. Recién vuelve a grabar cuando alguien baja el
    bit, que es lo que hace 'rtc clear'.
    La documentación que había escrito inducía a error —decía "el último corte"—,
    así que se corrige en el header y el comando lo aclara en pantalla. Sin esa
    línea, uno corta la alimentación tres veces, ve siempre la misma hora, y sale a
    buscar un bug que no existe.
    Queda anotada la consecuen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
    [drv_rtc79410.h, tkCmd.c]
2026-08-12 Firma en la SRAM del RTC: saber si la hora es confiable
    En cuatro cortes de alimentación seguidos el respaldo por pila aguantó tres y
    falló uno. Eso es hardware —perfil de contacto intermitente— pero destapó algo
    más importante: el firmware tiene que poder decir "esta hora no es confiable".
    Un datalogger que estampa 2001-01-01 en las muestras sin marcarlas es peor que
    uno que no estampa nada, porque los datos malos se mezclan con los buenos y
    después no hay forma de separarlos.
    Adivinar por la fecha es frágil: ¿qué año es "demasiado viejo"? El mecanismo es
    una firma de 5 bytes en la SRAM del propio MCP79410, y funciona porque la SRAM y
    el contador de tiempo se alimentan de LA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
2026-08-12 El día de la semana se calcula, no se pide
    En la primera prueba de banco quedó un miércoles cargado como domingo. El
    formato pedía los segundos antes del día de semana, el valor cayó en el lugar
    equivocado y el reloj quedó con un día que no correspondía a su fecha.
    Lo de fondo es peor que el error de tipeo: el MCP79410 NO calcula el día de la
    semana, sólo cuenta de 1 a 7 y da la vuelta. Un valor mal cargado queda mal para
    siempre, y nadie lo nota hasta que algo lo usa.
    Es un dato DERIVADO de la fecha. Pedirlo a mano era pedir que alguien se
    equivocara, y se equivocó en el primer intento. Ahora lo calcula el driver con
    el algoritmo de Sakamoto y drv_rtc_escribir() ignora lo que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
    [drv_rtc79410.c, drv_rtc79410.h, tkCmd.c]
2026-08-12 Postergar la sincronización del RTC a la etapa final de pulido
    Decisión de Pablo: se implementa cuando el hardware esté terminado, no ahora.
    El criterio es de método. Mientras se sigan poblando periféricos, el trabajo que
    rinde es bring-up; la sincronización es una optimización —evitar una transacción
    I2C por timestamp— que no habilita nada que hoy falte, y rehacerla cada vez que
    entra un periférico sería trabajo tirado.
    Se agrega un paso 9 al roadmap, "pulido final con el hardware ya terminado",
    donde caen las cosas que conviene hacer una sola vez y al final: la
    sincronización del RTC, el período de tkCtl junto con el watchdog y el poleo de
    TERM_SENSE (los tres comparten la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
2026-08-12 Driver del RS485: energía y rieles, con el DE por hardware
    Pinout verificado contra el datasheet (DS11585, tabla 16) antes de escribir nada,
    y menos mal: el primer pinout tenía RS485_RX en PB2, que NO tiene ninguna función
    de USART —sólo RTC_OUT, LPTIM1_OUT, I2C3_SMBA y DFSDM— y RTS en PB12, que es
    USART3_CK y no el DE. El pinout corregido cierra: PB10 USART3_TX, PB11 USART3_RX
    y PB1 USART3_RTS_DE, los tres en AF7.
    Que PB1 sea el DE del periférico y no un GPIO cualquiera es lo mejor de esta
    etapa: el USART levanta y baja el Driver Enable del SP3485 solo, con tiempos
    programables. Eso evita el bug más clásico del RS485, soltar el DE cuando se
    vació el registro de transmisión (TX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
    [FWDLGARM_R1.ioc, drv_rs485.c, drv_rs485.h, drv_uart.c, drv_uart.h, frtos-io.c, main.c, main.h]
2026-08-12 'help <comando>' muestra la ayuda específica de cada uno
    Pablo no encontró las opciones de 'rs485' porque el 'help' no las mencionaba: el
    comando tenía subcomandos para prender y apagar los tres rieles, existían y
    andaban, pero no había forma de descubrirlos sin leer el código.
    El resumen de cada comando estaba escrito adentro de cmdHelp() y el detalle
    adentro de cada prvXxxUso(), o sea en dos lugares que no se miran entre sí. Eso
    envejece mal por construcción, y envejeció.
    Ahora hay UNA tabla con las dos cosas. 'help' pelado lista los resúmenes y marca
    con [+] los que tienen más para contar; 'help <comando>' llama a su ayuda
    detallada. El matcheo es por prefijo, igual que el de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
2026-08-12 Arreglar el historial de comandos con flecha arriba
    El mecanismo estaba portado de FWDLGX pero con dos fallas, y por eso parecía no
    existir.
    1. Sólo reconocía el introductor '[' (modo CSI). Las terminales en modo
    "application cursor keys" —minicom, screen y PuTTY según cómo estén— mandan
    la flecha como ESC O A, no ESC [ A. Ahí la flecha no hacía nada y encima la
    'A' final se colaba en el renglón como si el usuario la hubiera tipeado.
    Ahora se aceptan los dos introductores.
    2. Al recuperar el comando no borraba lo que ya estaba escrito en pantalla. Con
    el renglón vacío se veía bien, pero con algo a medio escribir la pantalla
    mostraba lo viejo pegado a lo nu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
    [FWDLGARM_R1.ioc, frtos_cmd.c, main.c]
2026-08-12 Comando 'keys' para ver qué manda la terminal, y versión en el banner
    "La flecha arriba no muestra nada" tiene dos causas que desde el firmware se ven
    iguales: que el historial esté vacío, o que la terminal no mande NADA al apretar
    la flecha. Muchos monitores serie simples no mandan las teclas de cursor, y en
    ese caso no hay nada que arreglar de este lado.
    'keys' muestra el código crudo de cada tecla sin pasar por el parser. Al apretar
    flecha arriba tienen que aparecer tres bytes: 1B 5B 41 (ESC [ A, modo normal) o
    1B 4F 41 (ESC O A, application cursor keys). El parser entiende los dos desde el
    commit anterior. Si no aparece ninguno, el problema es la terminal.
    Es el mismo patrón que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
    [main.h, tkCmd.c]
2026-08-12 'keys' captura en silencio, y el driver cuenta errores de UART
    Con minicom, las cuatro flechas daban un solo byte (1B) en vez de los tres de
    ESC [ A. Eso deja dos causas muy distintas, y una sería un bug serio que también
    arruinaría Modbus: que estemos perdiendo bytes.
    Y el sospechoso número uno era el propio instrumento. La primera versión de
    'keys' imprimía cada byte ANTES de leer el siguiente, y a 9600 imprimir " 1B"
    son 3,1 ms: exactamente el tiempo en que llegan los otros dos bytes de la
    flecha. O sea que el diagnóstico podía estar causando el fenómeno que venía a
    medir, y hubiéramos terminado culpando a minicom.
    Ahora captura en silencio y recién al final imprime. Además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
    [drv_uart.c, drv_uart.h, tkCmd.c]
2026-08-12 Instrumentar el ISR crudo del USART, que la HAL no explica
    El 'keys' anterior dio, con tres flechas: tres bytes (1B 1B 1B) y TRES errores de
    UART, pero con las banderas de la HAL en 0x00000000. Eso último no lo explica
    ningún camino del stm32l4xx_hal_uart.c: el IRQ handler pone ErrorCode ANTES de
    llamar al callback, y sólo lo limpia después. O sea que la contabilidad de la HAL
    no cierra, y mientras no cierre no se le puede creer.
    Así que ahora se guarda el registro ISR CRUDO del periférico al entrar al
    callback, además del ErrorCode. No es redundante: el registro del hardware no
    depende de la bookkeeping de la HAL, así que dice la verdad justamente cuando esa
    bookkeeping está mal.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
    [drv_uart.c, drv_uart.h, tkCmd.c]
2026-08-12 TEMPORAL: anular el tickless para confirmar que nos come bytes del USART
    La comparación de 'keys' fue concluyente: la tecla ESC (un byte suelto) da 0
    errores, y la flecha (tres bytes pegados) da 3 errores y sólo sobrevive el
    primer byte de cada una.
    El mecanismo es vPortSuppressTicksAndSleep(). Hace __disable_irq(), que enmascara
    por PRIMASK TODAS las interrupciones sin importar la prioridad —así que subir la
    del USART no ayudaría—, y recién las habilita al final, después de parar y
    rearmar el LPTIM1 dos veces. Cada espera del flag ARROK son 3 ciclos de LSE, unos
    92 us; sumado el WFI, el vTaskStepTick y el HAL_ResumeTick, la ventana se acerca
    al tiempo de un byte a 9600, que son 1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
2026-08-12 Con un candado tomado, el idle gira: ni sueño ni supresión de ticks
    Implementa la política de energía que definió Pablo:
    terminal conectada -> nunca se entra en ningún modo de sueño
    poleo Modbus o modem -> la tarea levanta su candado antes y lo baja después
    el resto del tiempo -> Stop 2, que es el ~95 % y donde vive la autonomía
    vPortSuppressTicksAndSleep() ahora vuelve enseguida si hay algún candado tomado,
    ANTES de tocar el __disable_irq(). Eso es lo que arregla el bug: el problema
    nunca fue el modo de sueño sino la ventana de interrupciones cortadas que el
    tickless abría alrededor, y el camino viejo —dormir en Sleep con el candado
    tomado— sufría exactamente igu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
    [port_lptim_tick.c]
2026-08-12 Confirmado en banco: con el arreglo llegan los 9 bytes y 0 errores
    La flecha ×3 daba 3 bytes y 3 errores; ahora da 1B 5B 41 tres veces y ningún
    error. Queda el antes y el después juntos en la tabla, que es lo que hace útil
    una medición.
    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
2026-08-12 Leer TRAMAS del RS485, delimitadas por silencio
    El comando de escucha salía con el primer byte de la respuesta y el resto
    aparecía recién en la llamada siguiente. La culpa no era del RS485 sino de un
    comentario mío que mentía: drv_uart_read() prometía "bloqueante hasta juntar
    xBytes" cuando xStreamBufferReceive() vuelve apenas hay UNO. Para la consola esa
    semántica es la correcta —hay que atender cada tecla apenas llega— pero para
    hablar con un esclavo no sirve.
    Corregido el comentario, que es la mitad del arreglo: con esa promesa escrita,
    el próximo que use el driver se equivoca igual.
    Y aparece drv_uart_read_frame(): espera el primer byte hasta un plazo, y a
    partir de ahí ac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
    [drv_rs485.c, drv_rs485.h, drv_uart.c, drv_uart.h, tkCmd.c]
2026-08-12 CLAUDE.md: cerrar v0.0.8 — RS485 validado
    Rieles, transmisión y recepción probados en banco. Se actualizan el estado de la
    placa, el mapa de pines (con PB1 = USART3_RTS_DE y los tres rieles), el roadmap y
    la tabla de tags.
    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
2026-08-14 INA3221: medida de las entradas de 4-20 mA
    Driver del monitor de corriente (I2C2, direccion de 7 bits 41) y de la
    fuente lineal de los sensores, EN_PWR_SENS420 en PB12. Comando 'ina' en
    la consola: estado, riel, medida, registros crudos.
    Validado en banco contra un calibrador, de 4 a 20 mA: el ajuste da
    I_leida = 0,99770 * I_real + 0,002 y todos los residuos quedan por
    debajo de media cuenta (5,46 uA). O sea linealidad perfecta dentro de la
    resolucion del chip, y solo -0,23 % de ganancia, que es la tolerancia
    del shunt de 7,32 ohm. No se corrige en el driver a proposito: eso lo
    absorbe la calibracion de dos puntos de la capa de aplicacion.
    El consumo de reposo se remidio y sigue en su valo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
    [FWDLGARM_R1.ioc, drv_i2c.h, drv_ina3221.c, drv_ina3221.h, main.c, main.h, tkCmd.c]
2026-08-14 CLAUDE.md: el INA no tiene offset, era el lazo abierto
    Con 0 mA inyectados por el calibrador la lectura es correcta. Los
    -0,098 mA de la primera tanda eran la entrada flotando con el lazo
    desconectado, no un offset del chip.
    Queda anotada la advertencia de no usar ese numero como detector de
    sensor ausente: con el lazo abierto la entrada flota, asi que es una
    observacion y no una especificacion. El criterio correcto es el del
    propio lazo de 4-20 mA, por debajo de ~3,5 mA (NAMUR NE43 pone la falla
    en 3,6), y va en la capa de aplicacion.
    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
2026-08-14 CLAUDE.md: la lista completa de lo que falta poblar
    Pablo la dio el 2026-08-14: microSD, contador de pulsos, modem LTE,
    medidas analogicas de 3,3 y 12 V, y electrovalvula. Las dos ultimas son
    nuevas respecto del roadmap anterior; las analogicas van por el ADC del
    micro y no por el INA.
    Queda anotado que preguntarle de cada una cuando toque, para no perder
    la vuelta al banco averiguandolo.
    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
2026-08-14 microSD: driver de tarjeta SD por SPI (etapa 1, sin FatFs)
    Protocolo SD-SPI completo sobre SPI3, con la energia conmutada por
    EN_PWR_SD (PB3) y presencia por SD_DET (PD2): los 74 clocks iniciales,
    CMD0, CMD8, ACMD41, CMD58, CMD16, lectura y escritura de sector, CID y
    CSD con las dos versiones de formato. Comando 'sd' en la consola.
    Validado en banco con una SDHC de 4 GB:
    - La ranura vacia se distingue de la ocupada (el pull-up de PD2 hacia
    falta: habia quedado en NOPULL y el pin flotaba).
    - Inicializa como SDHC/SDXC y calcula 7610368 sectores, que coincide con
    el C_SIZE=0x1D07 de la CSD verificado a mano.
    - El CID sale en ASCII legible, lo que descarta problemas de reloj o de
    modo de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
    [FWDLGARM_R1.ioc, drv_sd.c, drv_sd.h, main.c, main.h, tkCmd.c]
2026-08-14 microSD: el pull-up de SD_DET vive y muere con el riel
    Medido: con el pull-up interno fijo, el reposo pasaba de 6 uA a 95 uA
    con solo INSERTAR la tarjeta, sin encenderla. El contacto de deteccion
    cierra a GND y el pull-up del STM32L4 son 30-50 kOhm: 3,3 V / 40 kOhm
    son 82 uA permanentes, contra los ~5 uA del micro dormido.
    Lo peligroso es que funcionalmente todo andaba bien. El pull-up hacia
    falta --sin el, el pin flotaba y la deteccion mentia-- y el unico
    sintoma era la corriente. En campo se habria visto como "la bateria dura
    menos de lo previsto", meses despues.
    La solucion la propuso Pablo y ademas simplifico el driver: la deteccion
    solo sirve justo antes de usar la tarjeta, y para usa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
2026-08-14 CLAUDE.md: FatFs queda para las capas de aplicacion
    Decision de Pablo el 2026-08-14, mismo criterio que Modbus: primero
    terminar de poblar el hardware. El driver de la tarjeta ya esta cerrado
    y validado; lo que falta de la SD es politica de datos, no bring-up.
    Queda anotado que la decision que destraba esa etapa --si la SD es
    almacenamiento primario o exportacion-- sigue abierta y hay que tomarla
    antes de escribir codigo.
    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
2026-08-15 ADC1: medida de los rieles de 12 V y 3,3 V (SIN VALIDAR EN BANCO)
    Primera etapa que usa el ADC del micro: hasta ahora lo unico analogico
    era 4-20 mA, y eso lo hace el INA3221 por I2C.
    ⚠ NO VALIDADO TODAVIA. Compila en Debug y Release; falta contrastar
    contra el tester y remedir el consumo de reposo.
    El riel de 3,3 V NO se puede medir con un ADC referenciado a el mismo:
    con el divisor 56K/56K de R001 la cuenta se cancela y da 2047 siempre,
    valga el riel 3,0 o 3,6 V. Sale por VREFINT, que es un valor absoluto
    calibrado de fabrica por chip, y ademas es mas preciso que el circuito
    --el divisor acumula la tolerancia de dos resistencias mas el offset del
    operacional--. El circuito quedo en la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
2026-08-17 ADC1: rieles validados en banco (v0.0.11)
    Las dos medidas coinciden con el tester y el consumo de reposo no se movio,
    que era lo unico que confirmaba que el ADC vuelve a deep power-down entre
    medidas.
    De paso queda anotada la firma de un clamp de entrada del operacional: el
    punto medio del divisor medido en 3,7 V (= riel + 0,6) con EN_SENS12V
    apagado, donde el nodo flota.
    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
2026-08-17 Contador de pulsos CNT0 por EXTI (SIN VALIDAR EN BANCO)
    El antirrebote lo hace todo el hardware -RC de 4K7/1uF mas el Schmitt del
    74AUP1G17-, asi que el driver solo suma flancos de bajada. Dos contadores
    independientes: uno libre para diagnostico y uno que 'tomar' descuenta de
    forma atomica, que es lo que va a necesitar el registro de muestras.
    Sin medida de periodo a proposito: adentro de la ISR el tick todavia no
    esta corregido por el tickless y la diferencia entre dos pulsos saldria
    cualquier cosa.
    Comando 'cnt' con watch, tomar y reset. Imprime PUPDR para cazar un pull
    interno que una regeneracion de CubeMX pudiera meter de vuelta.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
    [FWDLGARM_R1.ioc, drv_pulsos.c, drv_pulsos.h, main.c, main.h, tkCmd.c]
2026-08-18 Contador de pulsos CNT0 validado en banco (v0.0.12)
    El firmware no cambio: lo que fallaba era el optoacoplador, que con el
    contacto cerrado entregaba 72 uA contra los 4,93 mA del LED (CTR ~1,5 %,
    un opto sano da 20 a 600 %) y dejaba el colector en 2,53 V, un ALTO
    valido para el 74AUP1G17. Pablo lo corrigio en la placa y el contador
    quedo andando tal como se habia escrito.
    CLAUDE.md: etapa 11 del roadmap a validada, fila v0.0.12 en la tabla de
    tags, y la cuenta del CTR anotada como metodo de diagnostico para
    cualquier entrada que venga por opto.
    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
2026-08-18 Electrovalvula TOYI: driver del servo (SIN VALIDAR EN BANCO)
    Application/drivers/drv_valvula.{h,c} y el comando 'ev'. Es un servo, no
    una biestable: EN_EV_TOYI (PA6) lo alimenta por un TPS22810 y
    CTL_EV_TOYI (PA7) elige el sentido (1=abrir, 0=cerrar). Secuencia:
    direccion primero, energizar, esperar 5 s, cortar, y recien despues
    bajar CTL.
    No hay realimentacion de posicion: el estado que informa el driver es el
    ultimo comando ejecutado. Al arrancar se asume ABIERTA y tkCmd manda un
    cierre, que es asumir el estado peligroso y corregirlo.
    Sin candado de energia: los GPIO sobreviven al Stop 2, asi que el micro
    duerme durante los 5 s del recorrido. Mutex estatico para que dos
    movimientos no se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
2026-08-18 Valvula: el movimiento de arranque queda para la aplicacion
    tkCmd ya no manda el cierre al arrancar (decision de Pablo, 2026-08-18):
    en que condiciones conviene mover una valvula al energizar el equipo es
    politica de la capa de aplicacion, y un cierre automatico son 5 s de
    motor en cada reset, incluidos los de una sesion de flasheo.
    El driver sigue asumiendo ABIERTA al arrancar y lo hace visible con
    drv_valvula_estado_asumido(); la valvula se mueve solo si alguien lo
    pide.
    Documentado ademas el jumper que elige el riel del servo (12 V o 3,3 V):
    no cambia una linea de codigo pero si el modo de falla, porque en 3,3 V
    un atascamiento le baja el riel al micro y lo resetea a mitad de
    movimiento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
    [FWDLGARM_R1.ioc, drv_valvula.h, main.c, main.h, tkCmd.c]
2026-08-18 Electrovalvula TOYI validada en banco (v0.0.13)
    El servo abre y cierra con la secuencia direccion-energia-espera-corte, y
    el reposo quedo en los mismos 6 uA: ni el load switch ni los dos pines
    dejan fuga.
    Con esto todo el hardware poblado de R001 tiene driver. Falta un solo
    modulo por poblar, el modem LTE.
    Queda anotado como pendiente medir la corriente del movimiento -sobre
    todo la de atascamiento-, que es la que decide de que riel puede comer el
    servo.
    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
2026-08-18 Modem LTE etapa 1: las fuentes (SIN VALIDAR EN BANCO)
    Application/drivers/drv_lte.{h,c} y el comando 'lte'. Solo niveles: dos
    rieles y el PWRKEY, sin UART y sin pulso de encendido, que es la etapa 2.
    EN_LTE_DCIN (PC13, TPS22810) y EN_LTE_3V8 (PA4, TPS62130), las dos EN=1
    prende, con orden DCIN->3V8 al prender y al reves al apagar. LTE_PWR
    (PA5) drivea un transistor, asi que esta INVERTIDO: PA5=1 hunde el
    colector y el PWRKEY del modulo ve un bajo. Por eso la API dice
    'apretado' y no 'alto'.
    Documentado que PC13 esta en el dominio de backup: limitado a 3 mA y
    2 MHz (sirve de sobra para un pin EN), y sobre todo que si alguna vez se
    habilita RTC_OUT/TAMP/WKUP2 el pin deja de ser GPIO y esa co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
2026-08-18 CLAUDE.md: el campo que destraba el SWD es Mode, no Reset mode
    'No STM32 target found' viendo el reset del micro: en Normal o Hot plug
    CubeProgrammer pulsa NRST y despues intenta conectarse, y para entonces
    el firmware ya se durmio en Stop 2. Hay que poner Mode = Under reset, que
    mantiene NRST asertado durante la conexion. Reset mode y Frequency son
    otros dos campos, y ninguno de los dos alcanza.
    Verificado por CLI el 2026-08-18: mode=UR freq=950 conecta sin problema,
    con el riel en 3,26 V y Device ID 0x461.
    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
2026-09-04 Modem LTE validado en banco: la fuente nueva y la UART4 (v0.0.14)
    Con esto TODO el hardware poblado de R001 tiene driver y se termina el
    bring-up incremental.
    El modulo pasa a ser un WH-LTE-7S1-E (Cat-1 de USR IOT), no el SIM7080G:
    es un DTU, asi que del lado del micro es una UART y comandos AT, sin pila
    de red en el firmware. De aquel analisis solo sigue valiendo lo de la
    fuente, que es lo que dimensiono el LMR33630.
    ETAPA 1 - la fuente, sobre la placa NUEVA
    El riel quedo ajustado en 3,8 V. La topologia paso a CASCADA (el
    convertidor cuelga del load switch), asi que hay un solo interruptor:
    drv_lte_3v8(), drv_lte_rieles() y DRV_LTE_MS_ENTRE_RIELES se van, y
    queda drv_lte_power().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
2026-09-08 FASE 2: arranca el port de la aplicacion desde FWDLGX 2.0.12
    Cerrada la fase 1 (todo el hardware con driver), empieza el port de la
    aplicacion desde el firmware AVR que esta en produccion. La condicion
    dura que puso Pablo: **mantener el formato de los frames**, porque el
    servidor no se toca. El frame no es una decision de diseno, es un dato.
    Cuatro pasos, y los dos primeros validados en banco.
    PASO 1 - Configuracion persistente (validado)
    Application/config/: los 5 bloques (base, ainputs, counter, modbus,
    consigna) sobre la M24M01, porque el STM32 no tiene EEPROM interna
    como el AVR. 4 KB para configuracion, 124 KB para datos.
    El hash NO es un checksum de la struct: es un Pearson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
2026-09-09 Pasos 2, 4 y 4b validados en banco: analogicas, ventana y microSD
    Cinco pasos de la fase 2 validados. El almacenamiento queda cerrado de
    punta a punta: una muestra entra a la ventana en EEPROM, se vuelca a un
    lote de la microSD, y lo que queda en la tarjeta es literalmente el frame
    que se va a transmitir.
    LAS ANALOGICAS ENTRARON AL POLEO
    Pablo cambio el INA3221 -el viejo no contestaba en el I2C- y con eso se
    destrabo lo unico que faltaba del paso 2.
    El canal del INA NO es el numero de la entrada: a0 esta cableada al CH3
    del chip y a2 al CH1. Sale del switch de ainputs_read_channel_raw() del
    AVR, depende del cableado de la placa y no del chip, y Pablo lo
    confirmo para R001. Por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
2026-09-09 Paso 5a: el modulo se configura desde la consola y el PING anda
    El equipo enciende el modem, sabe quien es, y el servidor lo escucha:
    -> ID=860909055244702&HW=SPQ_ARM_R1&TYPE=FWDLGARM_R1&VER=0.0.36&CLASS=PING
    <- "<html>CLASS=PONG</html>"
    EL ESTADO DEL MODULO ES EXPLICITO
    Criterio de Pablo, copiado del AVR: un comando lo pone en modo AT y
    otro lo saca; los de configuracion ASUMEN ese estado y no lo cambian.
    Si no esta, fallan. 'lte esc' entra, 'lte exit' sale, y en el medio
    info/set/save solo hablan. 'lte ping' es al reves: asume TRANSPARENTE,
    porque en modo comando el modulo no transmite.
    Y elimina un bug de raiz. La primera version intentaba entrar "por las
    dudas" antes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
    [FWDLGARM_R1.ioc, main.c, main.h, tkCmd.c, wan_frame.c, wan_frame.h]
2026-09-11 Paso 5b: los frames de configuracion, y el contrato del hash CIERRA
    CONF_ALL con los cinco hashes y los CONF_* que el servidor pida: se parsea
    la configuracion que manda, se aplica, y se graba UNA sola vez al final.
    Validado en banco el 2026-09-11 contra el servidor real. El criterio de
    aceptacion no era que la configuracion se aplicara, sino que en la sesion
    SIGUIENTE el servidor dejara de pedir los bloques -- lo unico que prueba que
    nuestros strings del hash son identicos a los suyos. Paso: la segunda sesion
    pide solo FLOWC, que se ignora a proposito.
    Hashes de referencia: BH=0x8D AH=0xD7 CH=0xFA MH=0xBB PH=0x28
    AH=0xD7 era el valor PREDICHO por el test del host antes de tocar el equipo.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
2026-09-12 Paso 5c: el vaciado de la ventana, y los modos RTU y SILENT
    Escrito, SIN PROBAR en banco. Lo ultimo validado es 0.0.41 (paso 5b).
    --- 5c, primera mitad: 'lte data' -------------------------------------------
    Transmite los registros de la ventana y los borra recien cuando el servidor
    confirma. La estructura es la del AVR: bloques de 10 frames CLASS=DATANR y el
    que cierra como CLASS=DATA, que si espera respuesta.
    El borrado NO es el del AVR, y esa es la diferencia que importa. Aquel usa
    FS_readRcd(), que consume el registro ANTES de transmitirlo: si la sesion se
    corta, esos datos ya se perdieron. Aca se lee con fs_datos_peek(dr, offset) y
    se llama fs_datos_pop(n) solo tras la confirmacion -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
2026-09-19 Primera corrida de 'lte data' contra el servidor: tres hallazgos
    Escrito, SIN PROBAR. Version 0.0.47; lo ultimo validado en banco sigue siendo
    0.0.41 (paso 5b).
    --- Lo que SI funciono ------------------------------------------------------
    Los 10 frames seguidos NO se pegaron: el servidor los recibio todos. Era el
    riesgo principal del paso 5c -- el modulo delimita por silencio y el AVR solo
    tiene una pausa accidental de ~150 ms por imprimir el frame en la consola --
    y quedo descartado con la pausa explicita de 500 ms.
    --- 1. El comando NO se llama AT+FTIME --------------------------------------
    Devuelve +CME ERROR:58. Los reales son dos, y el modulo cierra la trama con el
    que se cumpla PR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
    [main.h, tkCmd.c, tkSys.c, tkSys.h, wan_frame.c, wan_frame.h]
2026-09-21 El vaciado de la ventana ANDA: la causa era una carrera, no la fecha
    Validado en banco el 2026-09-21 contra el servidor real:
    (se descartaron 3 acuses vacios de DATANR anteriores)
    <- "<html>CLASS=DATA&CLOCK=2609211452</html>"
    OK: 10 registros confirmados y borrados de la ventana
    --- El hallazgo, que solo se pudo cerrar con el log del SERVIDOR ------------
    El sintoma era que la respuesta al CLASS=DATA llegaba como "<html></html>",
    sin un solo CLASS=. Parecia que el servidor habia recibido el frame y lo habia
    rechazado por su contenido, y la sospecha natural era la FECHA, porque esos
    registros viajaban con DATE=010101.
    Era falso, y el log lo desmiente por dos lados:
    raw_response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
2026-09-21 En la microSD va solo la parte de datos, no el frame entero
    Decision de Pablo (2026-09-21), a partir de una sola pregunta suya: "que datos
    escribimos en la microSD? solo los datos o los frames?".
    Se guardaba el frame ENTERO, y eso metia campos de TRANSPORTE dentro de un
    archivo de DATOS:
    ID=..&HW=..&TYPE=..&VER=..&CLASS=DATA&DATE=..&TIME=..&<canales>&V0=..
    |________ transporte: se construye al transmitir ____||___ el dato ___|
    El que duele es el ID: es el IMEI del modulo. Un lote que quede pendiente y se
    transmita despues de cambiar el modulo LTE saldria con el IMEI VIEJO, y el
    servidor lo atribuiria a otro equipo o lo rechazaria. No es hipotetico -- el
    modulo de este banco ya se movi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
2026-09-21 Paso 5c VALIDADO: ventana y lotes. Y se transmitio con el IMEI falso
    Banco, 2026-09-21: los cuatro lotes transmitidos y borrados, y 'fs sd list'
    quedo vacio.
    Los dos formatos de lote convivieron en la misma corrida: LOTE0001/2/3 eran del
    formato viejo (ID=..&TYPE=FWDLGARM_R1&VER=0.0.30) y salieron tal cual;
    LOTE9041 es del nuevo y se armo al transmitir. Los cuatro confirmados.
    De paso quedo validado el caso de uso principal de 'lte clock': el equipo
    estaba en arranque frio (01/01/01, NO CONFIABLE) y salio de ahi sin que nadie
    fuera al sitio.
    --- El hallazgo: el IMEI falso -----------------------------------------------
    En esa corrida los frames salieron con ID=000000000000000. El IMEI se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
2026-09-21 Paso 5d: tkWan, la FSM. El equipo transmite solo
    Portada de FWDLGX_tkWAN.c. Los cuatro estados son los del AVR --APAGADO,
    OFFLINE, ONLINE_CONFIG, ONLINE_DATA-- y CUALQUIER fallo vuelve a APAGADO: un
    fallo a mitad de sesion deja al modulo en un estado que desde afuera no se
    puede saber (puede haber quedado en modo AT, con una respuesta a medio llegar),
    asi que apagarlo y empezar de nuevo es lo unico que garantiza un punto de
    partida conocido.
    --- La sesion de la FSM es la MISMA que hacen los comandos --------------------
    Todo el 5a-5c se valido primero como comandos, uno por uno contra el servidor
    real. Ese codigo SE MOVIO aca --875 lineas desde tkCmd.c-- en vez de
    duplicarse, y 'lte ping'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
2026-09-21 El AT+ENTM nunca se mandaba, y el PING se reintenta 5 veces
    Primera corrida de la FSM en banco. La traza mostraba el frame del PING
    volviendo IDENTICO seguido de '+CME ERROR:58', y la sesion reintentando sin
    parar.
    --- La causa: una linea, y el (void) la tapaba ---------------------------------
    ( void ) drv_lte_at( "AT+ENTM", NULL, 0U, 0U );
    drv_lte_at() RECHAZA pcRta == NULL devolviendo -1 antes de escribir un byte, y
    era el unico llamador del arbol que le pasaba NULL. O sea que el comando no
    salio nunca y el modulo siguio en modo AT, donde no transmite nada.
    La firma que lo identifica --y conviene aprenderla, porque el sintoma manda a
    mirar la red-- es EL ECO: la respuesta es el fr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
    [main.c, main.h, tkWan.c]
2026-09-21 Paso 5d VALIDADO: el equipo hizo la vuelta entera solo
    Banco, 0.0.58. APAGADO -> OFFLINE -> ONLINE_CONFIG -> ONLINE_DATA sin que nadie
    tipeara nada, que era el unico criterio de aceptacion que las piezas sueltas no
    podian demostrar.
    PING : al primer intento (los 5 reintentos no hicieron falta)
    CONF_ALL : el servidor pide SOLO FLOWC -> el hash sigue cerrando en la FSM
    vaciado : 48 de 48 en 5 bloques, con 3-4 acuses rezagados descartados
    count : "transmitidos 48, quedan 1" -- el que tkSys grabo en el medio
    CONTINUO : queda en ONLINE_DATA esperando timerpoll, sin reabrir la sesion
    De paso quedo validado el mensaje de progreso "OK: N de M ... quedan X" que
    Pablo pid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
2026-09-21 Paso 6a: el motor Modbus RTU, en dos capas
    Pablo lo puso antes que las consignas, y el relevamiento confirmo que es el
    orden correcto: la consigna del control de presion ES Modbus (FC03/FC06 contra
    el esclavo 0x64, registro 1), asi que el paso 7 no se puede hacer sin esto.
    La configuracion ya estaba desde el paso 1 (cfg_modbus, con su hash MH validado
    contra el servidor), el riel y el candado de energia desde v0.0.8. Faltaba solo
    el motor.
    --- Dos capas, porque el AVR tiene DOS caminos para hablar Modbus -------------
    En FWDLGX conviven modbus_io() --atado a la struct del canal-- y cpres.c, que
    arma las tramas BYTE A BYTE A MANO con su propio llamado a modbus_CRC16(),
    porque solo quiere l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
    [drv_modbus.c, drv_modbus.h, main.h, modbus.c, modbus.h, tkCmd.c]
2026-09-21 Paso 6a VALIDADO contra un esclavo real: la tabla de codecs predijo los valores
    Banco, 2026-09-21. Leyendo el registro 4118 del esclavo 9 como U32:
    TX [09][03][10][16][00][02][20][47]
    RX [09][03][04][00][00][02][FE][F3][13] -> 766.000
    Y el MISMO registro con otro codec da 50200576.
    El criterio que cierra el paso: corriendo el codigo real sobre el payload
    00 00 02 FE que devolvio el esclavo, C3210 da 766 y C1032 da 50200576 --
    exactamente los dos valores que informo el equipo. Y el CRC calculado sobre las
    dos tramas de esa sesion coincide con el que viajo por el cable.
    Los 60 casos contra el AVR probaban que copiamos bien el firmware viejo; esto
    prueba que funciona contra un disposit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
2026-09-21 Paso 6b: el Modbus entra al poleo, y un bug al juntar las dos tareas
    Los canales habilitados se leen en cada ciclo y quedan en dr->fModbus[], de
    donde los toma el frame. Usa modbus_leer_canal(), la MISMA funcion que el
    comando 'modbus ch' -- mismo criterio que poll/tkSys_poll y que
    lte data/wan_sesion_datos.
    --- El riel del modulo se prende TEMPRANO -------------------------------------
    Un caudalimetro tarda segundos en arrancar. El AVR prende EN_PWR_QMBUS ANTES de
    medir las analogicas, asi ese arranque transcurre durante el barrido de 1,4 s
    del INA3221: el tiempo total es el mismo pero NO SE PAGA.
    Aca lo mismo con una mejora: en vez de esperar "2 s mas" como el AVR --un numero
    que deja d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
    [main.h, tkSys.c, tkSys.h, tkWan.c, tkWan.h, wan_frame.c]
2026-09-21 Paso 6b VALIDADO, y un bug propio: los canales se imprimian dos veces
    Banco, 2026-09-21. Dos canales configurados, uno contra el esclavo real y otro
    contra una direccion que no contesta:
    MODBUS:: ch1 [qa0] SIN DATO: SIN RESPUESTA (timeout)
    ...;CAU0=766.000;qa0=SIN_DATO;V0=0;...
    [!] campos sin dato (0x0100): modbus
    ...&CAU0=766.000&qa0=-9999.000&V0=0&...
    El canal bueno da el mismo valor que el comando 'modbus read'; el muerto dice
    SIN_DATO en consola y viaja como -9999; el bitmask 0x0100 es el bit 8, o sea el
    canal 1, como corresponde.
    --- El bug ---------------------------------------------------------------
    La primera corrida mostro los canales DOS VECES:
    CAU0=766.000;qa0=S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
    [main.h, tkSys.c]
2026-09-22 Paso 7: la doble consigna del control de presion
    drv_cpres (el dialogo) + tkCtlPres (cuando) + el comando 'cpres'. Esclavo 0x64,
    registro 1, riel EN_PWR_CPRES. Por esto el paso 6 iba antes: sin el motor Modbus
    esto no se puede hacer.
    --- Una consigna no es una escritura: es una SECUENCIA que tarda ---------------
    El dato lo dio Pablo y no esta en el codigo del AVR: las electrovalvulas se
    mueven DE A UNA, por consumo. O sea que el FC06 solo arranca el trabajo.
    Por eso el bit 7 = RUN, y por eso el dialogo son tres pasos: esperar IDLE,
    escribir, esperar IDLE otra vez. Una consigna tarda 30-45 s, y durante casi todo
    ese tiempo el micro DUERME: lo unico encendido es un GPIO.
    --- El dispositiv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
2026-09-22 Tres arreglos de la consola, y el help que mentia
    Pedidos de Pablo:
    1. modbus y cpres no figuraban en el help. Registrar un comando y agregarlo a la
    tabla de ayuda son dos pasos independientes, y el segundo se olvida facil
    porque el comando funciona igual.
    2. status dice si cada tarea esta viva o matada. Hacia falta porque el kill es
    COOPERATIVO: entre pedirlo y que ocurra pasa hasta una vuelta entera de esa
    tarea, y no habia forma de confirmar que se hubiera suspendido.
    Se informan los dos estados por separado --MATADA cuando eTaskGetState() dice
    eSuspended, y "kill PEDIDO (todavia corriendo)" cuando la bandera esta puesta
    pero la tarea no llego-- porque confundirlos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
    [main.h, tkCmd.c]
2026-09-22 El bus mete un byte de ruido y la lectura lo tomaba por la respuesta
    Primera prueba contra el control de presion:
    MB TX (8):[64][03][00][01][00][01][DC][3F]
    MB RX (1):[00] <- y ahi se cortaba
    La trama de salida era IDENTICA byte a byte a la capturada del AVR, asi que ese
    lado estaba descartado de entrada.
    Lo que cerro el diagnostico fue pedirle a una direccion que NO EXISTE: la 99
    devolvio exactamente el mismo [00]. O sea que el byte lo genera el BUS, no el
    esclavo -- es el artefacto que deja la linea al soltarse el DE: sin nadie
    manejando el par, el receptor ve un nivel indefinido, interpreta un start bit
    falso y entrega un byte de ceros.
    El mismo metodo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
2026-09-22 El control de presion no devuelve el eco del FC06: devuelve su status
    Salio de leer su firmware, que Pablo paso hoy, y habria hecho fallar la consigna
    SIEMPRE:
    /* modbus_slave_process_frame06() */
    mbus_cb.tx_buffer[4] = 0x0; // Reg.value
    mbus_cb.tx_buffer[5] = systemVars.status_register; // <- el STATUS
    Sus propias capturas lo muestran: a un pedido de 05 contesta 01, y a uno de 06
    contesta 04. drv_modbus_escribir() exigia el eco DEL VALOR y lo habria rechazado
    en cada orden.
    Ahora se verifica solo la direccion del registro, que si es eco y sigue teniendo
    valor: un esclavo que conteste sobre otro registro no entendio el pedido.
    Y el valor devuelto paso de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
2026-09-22 El dialogo con el control de presion ANDA, y el status confirma lo predicho
    Banco, 2026-09-22. Con el arreglo del ruido:
    MB: descartados 1 byte(s) de ruido antes de la respuesta
    MB RX (7):[64][03][02][00][0A][74][4B]
    El diagnostico cerro exacto: habia un byte de ruido y nos ibamos antes de que
    llegara la respuesta.
    Y el 0x0A confirma EN VIVO lo que Pablo habia dicho del dispositivo:
    bit 7 = 0 -> IDLE
    bits 1-0 = 10 -> V0 DESCONOCIDA
    bits 3-2 = 10 -> V1 DESCONOCIDA
    Recien encendido no sabe donde estan las valvulas y lo dice en las dos. El
    valor 2 que en el codigo del AVR parecia un caso raro es el estado NORMAL al
    arranca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
    [main.h, tkCmd.c]
2026-09-22 La espera larga es por el MOVIMIENTO, no por el arranque
    Dato de Pablo, y corrige un tiempo que estaba mal repartido: "en la medida que
    NO movemos las electrovalvulas, no hay que esperar mas de 1 segundo para que el
    micro de la doble consigna se active y responda. La espera larga es solo cuando
    damos algun comando que mueve las valvulas."
    El AVR espera 10 s antes del primer dialogo y yo lo habia copiado suponiendo que
    el dispositivo tardaba en estar listo --su tarea de RS485 aguarda un
    starting_flag, lo cual parecia confirmarlo--. No es asi: esos 10 s eran
    precaucion heredada.
    leer el status sin mover nada : 12 s -> 1 s
    un ciclo de consigna completo : ~45 s -> ~14 s
    Sigue sin medir cu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
    [drv_cpres.c, drv_cpres.h, main.h, tkCmd.c]
2026-09-22 Paso 7 VALIDADO: la consigna se aplica sola, y status informa la ultima
    Banco, 2026-09-22. Con diurna=1222 y el reloj en 12:21:59:
    tkCtlPres:: son las 12:22 -> consigna DIURNA
    CPRES:: consigna DIURNA
    CPRES:: orden aceptada, status 0x0A (todavia IDLE)
    CPRES:: consigna DIURNA: OK
    La tarea disparo sola a la hora exacta, el ciclo termino OK y no se repitio
    dentro del minuto -- o sea que la espera al cambio de minuto hizo lo suyo.
    --- "todavia IDLE" es lo NORMAL, y desmiente un comentario mio ----------------
    Ayer anote que el valor devuelto por el FC06 era "el status con el bit RUN ya
    puesto, o sea la confirmacion de que el trabajo arranco". La traza lo desmiente:
    devolvio 0x0A --IDL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
2026-09-22 Paso 7b: flowcontrol con alcance recortado, y el sexto hash
    El nombre engaña: NO tiene nada que ver con el caudal. Estuvo anotado como que
    dependia del 2b y es falso -- salio al relevarlo porque Pablo pregunto que era.
    Flowcontrol es un temporizador semanal para la electrovalvula TOYI interna: 14
    slots {dia, hhmm, abrir|cerrar}.
    Y aclara una division que estaba difusa:
    VOPEN / VCLOSE -> tkFlow : la valvula TOYI INTERNA
    EXT_V0/V1_OPEN|CLOSE -> tkCtlPres : las del control de presion
    Yo las tenia juntas como "lo que falta del paso 7": son dos destinos distintos.
    Con las EXT_* enganchadas, el paso 7 queda cerrado.
    --- El alcance que fijo Pablo ------------------------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
2026-09-22 Los slots del flowcontrol: se aceptan S0= y S00=
    Pablo aclaro el alcance: "La idea es que la configuracion del flowcontrol
    funcione. Lo que manda el servidor debe configurarse en el datalogger. Lo que NO
    hacemos es implementar la tarea que abra y cierre de acuerdo a la tabla."
    Eso ya estaba --el bloque se aplica y se graba en la EEPROM-- pero al revisar el
    parseo aparecio que el comentario del AVR y su codigo SE CONTRADICEN:
    comentario: ...&S0=LU,1230,OPEN&S1=MA,650,CLOSE&...&S13=... (un digito)
    codigo: snprintf_P( str_base, ..., PSTR("S%02d"), slot ) (dos digitos)
    Si el servidor manda un digito, el AVR NO ENCUENTRA los slots 0 a 9 y solo
    configura del 10 al 13. Puede ser un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
2026-09-22 Los slots del flowcontrol venian con ':' y no con '='
    Banco, 2026-09-22. La respuesta real del servidor:
    CLASS=CONF_FLOWC&ENABLE=FALSE&S00:--,0000,CLOSE&S01:--,0000,CLOSE&...
    ^ con '=' ^ con ':'
    El ENABLE viene con '=' y los slots con ':'. Buscando "S00=" no matchea nada,
    asi que no se configuraba ningun slot.
    El AVR no lo sufre justamente por lo que aca se habia "mejorado": el busca
    strstr(p,"S00") SIN separador y recien despues tokeniza con &,;:= -- incluir el
    '=' en la busqueda daba mas precision y costaba compatibilidad.
    Criterio de Pablo: "El servidor debe mandar tokens similares (el mismo
    separador) en todas las configuraciones. Si no, ajusto el s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
2026-09-22 Se elimina FLOWCONTROL entero: no se usa
    Decision de Pablo: "Eliminamos todo lo que tiene que ver con FLOWC. Esta es una
    funcionalidad que aun no la estamos usando asi que no vamos a ensuciar el
    firmware con features que no se usan. Ya modifique el servidor de modo que no
    responda mas a la configuracion con un FLOWC. Tampoco tenemos que mandar el
    hash."
    Se borro: cfg_flowcontrol.{h,c}, su bloque en la EEPROM, el hash FH, el
    CONF_FLOWC, su aplicador y los comandos 'config flow'. Las dos puntas estan de
    acuerdo: el servidor ya no lo pide y el equipo manda cinco hashes.
    Esto NO es volver a la situacion transitoria de antes: hasta el 2026-09-11 se
    mandaban cinco porque el bloque no existia Y E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
2026-09-22 CONFIG=OK: el contrato de configuracion cierra completo, por primera vez
    Banco, 2026-09-22, con 0.0.73:
    -> ...&CLASS=CONF_ALL&...&BH=..&AH=..&CH=..&MH=..&PH=..
    <- "<html>CLASS=CONF_ALL&CONFIG=OK</html>"
    Es la primera vez. Hasta aca CONF_ALL no podia contestar OK ni con la
    configuracion perfecta: el servidor pedia un FLOWC que el equipo no mandaba, y
    eso era estructural, no un desajuste. Con el bloque eliminado de las dos puntas,
    los cinco hashes son el contrato entero.
    Cierra una cadena que empezo el 2026-09-11: la prediccion del hash en el host,
    la aplicacion en el equipo, la aceptacion del servidor, y ahora el acuerdo
    completo.
    La vuelta salio entera: PING -> CONF_ALL con OK -> ONL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
2026-09-22 Paso 8: el watchdog cooperativo sobre el IWDG
    Plazo UNICO de 90 s para las cinco tareas vigiladas, y las esperas largas
    troceadas a 60 s con un reporte en cada trozo. Es el mecanismo del AVR y lo
    corrigio Pablo: que cada tarea declarara su propio plazo haria que un cuelgue
    de tkWan en modo DISCRETO tardara seis horas en detectarse.
    tkCtl es el juez y no tiene ningun "resetear ahora": cuando una tarea vence,
    deja de patear y el IWDG resetea por su cuenta en ~32 s. Se usa el IWDG y no
    NVIC_SystemReset() porque la causa queda en RCC_CSR.IWDGRSTF y viaja al
    servidor en el campo WDG del CONF_BASE; un reset por software saldria como
    SOFT, indistinguible de un 'reset' tipeado por un tecnico.
    wdg_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
    [drv_wdt.c, drv_wdt.h, frtos_cmd.h, main.h, tkCmd.c, tkCmd.h, tkCtl.c, tkCtlPres.c]
2026-09-22 Suite de banco: el esqueleto y las areas A y B
    Un script que corre la bateria de comandos por la consola TERM, analiza las
    respuestas y da un veredicto, para validar cada version de firmware de forma
    sistematica en vez de a mano con el minicom. Pedido de Pablo.
    Las pausas interactivas son lo que define el alcance: el script no se limita a
    lo automatizable, ORQUESTA la sesion de banco entera --"saca la microSD",
    "conecta el esclavo Modbus"-- y verifica el resultado despues de la
    confirmacion. Un SKIP se ve distinto de un FAIL, asi que correr sin el esclavo
    conectado no ensucia el reporte con fallas falsas.
    El transporte es un hilo lector continuo y no un "mandar y leer la respuesta",
    porque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
    [dlg.py, runner.py, suite.py, tests_a_identidad.py, tests_b_config.py]
2026-09-23 wdg colgar: la herramienta que faltaba para probar el watchdog
    Sin esto NO hay forma de provocar un cuelgue y verificar que el perro muerde:
    'kill' justamente DESREGISTRA la tarea --si no, el watchdog resetearia el
    equipo mientras el operador trabaja a mano-- y un breakpoint no sirve porque
    drv_wdt_arrancar() congela el IWDG con __HAL_DBGMCU_FREEZE_IWDG() a proposito.
    Un watchdog que nunca se vio morder no es un watchdog validado: es codigo que
    compila.
    El comando mete a tkCmd en un lazo infinito sin reportar. El contador es
    volatile para que sobreviva a -Os: un lazo sin efectos observables es
    comportamiento indefinido en C11 y el compilador puede eliminarlo.
    Exige EXACTAMENTE un argument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
    [main.h, tkCmd.c]
2026-09-23 Suite de banco: areas G (transmision) y H (watchdog), validadas contra el equipo
    Las cuatro areas implementadas dieron 21/21 contra el equipo real (0.0.76) y el
    servidor apicomms corriendo en la misma PC.
    AREA H - el watchdog. Cierra 7 de los 8 pasos del plan:
    - el perro corre y vigila a las cinco tareas
    - 'kill' desregistra: matar una tarea NO resetea el equipo (206 s de espera,
    porque la muerte es COOPERATIVA y tkWan puede estar en un trozo de 60 s)
    - 'lte bridge' abierto 150 s sin tipear no resetea
    - las dos prorrogas de la microSD (manuales: necesitan tarjeta)
    - el cuelgue provocado, y la causa llegando al servidor como WDG=3
    AREA G - la transmision, y mira LAS DOS PUNTAS. Tres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
    [runner.py, suite.py, tests_g_transmision.py, tests_h_watchdog.py]
2026-09-23 La suite mira SOLO el log del datalogger: el servidor se asume bien
    Criterio de Pablo (2026-09-23): "me interesa tener los scripts de test pero que
    el servidor sea independiente... en algun momento el servidor puede estar en
    otra maquina y no disponer de acceso a los logs. El testing debe asumir que el
    servidor anda bien".
    La version anterior del area G leia el log de apicomms para cotejar frame por
    frame lo transmitido contra lo registrado. Era mas informacion, pero ataba la
    suite a tener acceso a la maquina del servidor: en cuanto el servidor se mueve,
    el test deja de correr por una razon que no tiene nada que ver con el firmware.
    Y no hace falta: LA RESPUESTA DEL SERVIDOR YA VIAJA POR L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
2026-09-23 Documentacion: cuatro pendientes de hardware que ya no lo son
    Todos con datos de Pablo del 2026-09-23, y ninguno necesito tocar una placa.
    LA VALVULA TOYI TIENE FIN DE CARRERA. Al llegar al tope --abierto o cerrado--
    un switch desconecta el motor, asi que NO hay atascamiento. El analisis de
    energia que estaba escrito describia un servo empujando contra el tope hasta
    que alguien le cortara la energia, y eso no es lo que pasa.
    Consecuencia para el driver, y es la que importa: los 5 s NO son "5 segundos de
    motor". Son el recorrido real mas un margen, y el margen NO CUESTA ENERGIA
    porque para entonces el switch ya corto. Alargarlo es gratis, acortarlo es lo
    riesgoso -- el numero salio de medid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
2026-09-23 Paso 2b: el caudal del contador, simplificado
    El dato que va al servidor es el CAUDAL, no los pulsos, y se deduce del tiempo
    entre dos de ellos. Con esto el campo del contador deja de viajar como -9999 y
    el equipo alcanza la paridad funcional con FWDLGX.
    ⭐ ES UNA VERSION SIMPLIFICADA DEL AVR, Y ESA ES LA DECISION DEL PASO.
    contadores.c trae ~200 lineas: EMA con cuatro alphas por tramo, fronteras
    precalculadas, clamp de slew-rate al ±10% y ventana de arranque de 5 pulsos.
    Todo eso existe porque habia ruido que se colaba y se medía como caudal. Se
    saco, con tres datos de Pablo: el criterio simple es mejor que complejo; en
    regimen no hay variaciones bruscas (es agua potable en redes); y l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
2026-09-29 Instrumento de banco para el consumo: PATRON_CONSUMO
    El equipo anda pero la placa nueva despoblada consume ~390 uA donde deberia
    consumir decenas. Esta tanda no lo arregla: acota el problema y deja el
    instrumento con el que se acoto.
    PATRON_CONSUMO en main.c, con el mismo mecanismo que PRUEBA_MINIMA: bare-metal,
    sin FreeRTOS, todos los pines en analogico, LSE + RTC vivos, Stop 2 permanente.
    Dio 3 uA en la placa nueva despoblada, asi que el micro, la soldadura y la placa
    quedan descartados.
    PC_PERIFERICOS es un bitmask para sumarle periodicos de a uno y bisectar desde
    ese punto conocido-bueno.
    Descartados con su medicion, y anotados en CLAUDE.md:
    - el firmware de aplicacion: v0.0.14 mide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
    [main.c]
2026-09-29 Etapa 1 del bring-up del consumo: FreeRTOS y una sola tarea
    Se reempieza la numeracion en 0.0.1. Desde los 3 uA que dio PATRON_CONSUMO se
    reconstruye hacia arriba agregando UNA cosa por etapa, en vez de quitarsela al
    firmware completo: eso ya costo dos bajadas de firmware sin resultado.
    La etapa 1 es SystemClock_Config + MX_LPTIM1_Init + una tarea que destella el
    LED a 1 Hz (50 ms encendido). Nada mas.
    No llama a MX_GPIO_Init: los pines quedan como los dejo el reset, en analogico,
    que es el estado con el que se midieron los 3 uA. Configurar los pines de R001
    es una etapa propia, porque es uno de los sospechosos.
    Tres destellos antes de arrancar el scheduler, como marca: separan "no arranc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
    [main.c, main.h]
2026-09-29 Etapa 2: los pines de R001 completa (MX_GPIO_Init)
    La etapa 1 dio 3 uA, asi que FreeRTOS, el tick por LPTIM1 y el tickless estan
    limpios y no cuestan nada.
    La etapa 2 agrega una sola llamada, MX_GPIO_Init(), que configura los pines de
    R001 entera. En una placa despoblada eso deja siete entradas sin quien las fije:
    TERM_RX, RS485_RX, LTE_RXD, las dos del I2C2, SD_MISO y CNT0.
    ETAPA2_SIN_EXTI separa las dos formas en que un pin cuesta consumo, que se
    arreglan distinto: la fuga del buffer de entrada de un pin flotando, y las
    despertadas que genera un pin EXTI sin nadie que lo maneje. Lo segundo no es
    fuga: cada flanco espurio saca al micro de Stop 2 y le hace rehacer
    SystemClock_Config().
    Co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
    [main.c, main.h]
2026-09-29 Etapa 3: los perifericos de CubeMX, con bitmask para bisectar
    La etapa 2 dio 8 uA: los pines de R001 cuestan 5 uA, no 387. Quedan descartados
    como causa, aunque esos 5 uA son fuga real de las siete entradas flotando.
    La etapa 3 agrega los perifericos con sus MspInit. ETAPA3_PERIF es un bitmask:
    0xFF para reproducir y despues busqueda binaria, tres bajadas hasta el bit.
    LPTIM1 no esta en el bitmask porque ya entro en la etapa 1: el tick del kernel
    lo necesita.
    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
2026-09-29 Etapa 4: las tareas del firmware, con bitmask
    La etapa 3 dio 1,15 mA, o sea MAS que el firmware completo (~390 uA). Eso dice
    que es un estado que el equipo real nunca tiene: CubeMX deja los perifericos
    recien inicializados y son los DRIVERS los que los ponen en reposo -el ADC en
    deep power-down, el INA dormido, los rieles cortados-. El candidato del 1,15 mA
    es el ADC1.
    Por eso no conviene bisectar la etapa 3: mediria un estado artificial. La etapa 4
    agrega las tareas, y a los drivers los inicializa tkCmd, asi que con 0x01 la
    prediccion es que el consumo BAJE hacia los 390 uA. Si baja, el firmware queda
    reproducido y desde ahi se bisecta sobre lo real.
    tkCtl no entra en el bitmask: su lugar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
2026-09-29 La consola entra al ensayo: destello + TERM + tkCmd (0.0.5)
    Pablo poblo la puerta serial, asi que la etapa que corresponde es el destello de
    la etapa 1 mas la consola. No hizo falta codigo nuevo: es la etapa 4 con
    ETAPA3_PERIF 0x7D y ETAPA4_TAREAS 0x01.
    Tres cosas que definen esa combinacion:
    - tkCmd arrastra los drivers -frtos_open_all, drv_rtc_init, drv_ina_init y
    varios mas-, asi que I2C2, USART3, UART4 y SPI3 tienen que estar
    inicializados o la HAL se llama con handles en blanco.
    - El ADC1 queda AFUERA: es el candidato del 1,15 mA de la etapa 3, porque
    MX_ADC1_Init lo deja habilitado y es drv_adc quien lo duerme.
    - MX_GPIO_Init va incluido, y no por los 5 uA que cuesta: sin el, P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
2026-09-29 La consola no andaba porque faltaba el poleo de TERM_SENSE (0.0.6)
    prvTareaLed reemplazo a tkCtl para el destello, pero tkCtl hace dos cosas en esa
    misma vuelta y la segunda no se repuso: polear TERM_SENSE. Sin ese poleo nunca
    se toma pwrLOCK_TERM, el equipo se queda en Stop 2 y la USART no puede recibir.
    Lo confirma la medicion de Pablo: con la terminal conectada, 0,5 mA. Si el
    candado se tomara serian ~3,5 mA, porque el port baja a Sleep y deja el PLL a
    60 MHz. Ese numero es lo que delata que el candado no se tomo.
    El poleo va solo desde la etapa 4: antes no existe tkCmd, que es quien llama a
    drv_term_sense_init().
    Claude-Session: ht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
